tsgwiro1/TWM_Isolation_Variac/README.md

# TWM Isolation Variac

Steuerung für einen motorisierten **Trenn-/Stelltransformator (Isolation Variac)**. Das Projekt
umfasst zwei zusammenarbeitende Firmwares sowie die gemeinsame Dokumentation in einem Mono-Repo.

Der **Controller** (`tt_esp32controller/`, ESP32-S3) fährt über einen Schrittmotor den Schleifer
des Variac und stellt so die Ausgangsspannung ein. Bedienung wahlweise lokal — TFT-Display,
Drehencoder und Tasten (Ein/Aus, Strombegrenzung, Regelung, 3 Presets) — oder über das integrierte
**Web-Interface** mit REST-/WebSocket-API. Dazu kommen temperaturgeregelte Lüftersteuerung,
WLAN-Einrichtung per WiFiManager und Updates over-the-air (OTA).

Das **Voltmeter** (`tt_voltmeter/`, STM32F103) misst die Ausgangsspannung als echten AC-RMS-Wert
(ZMPT101B-Sensor) und liefert ihn laufend über eine serielle Verbindung an den Controller — die
Basis für die geschlossene Spannungsregelung.

**Stand:** Controller-Firmware **V4.9.1** (Git-Tag `v4.9.1`) · Voltmeter-Firmware **V1.2.3**.

Das Projekt auf einer Seite: [`TWM-Isolation-Variac-OnePager.pdf`](TWM-Isolation-Variac-OnePager.pdf).

## Aufbau

| Pfad | Inhalt |
|---|---|
| `tt_esp32controller/` | Controller-Firmware (PlatformIO/Arduino), Web-Oberfläche (`data/`), Controller-Doku (inkl. Trinamic-Treiber, Hardware-Modifikationen) |
| `tt_voltmeter/` | Voltmeter-Firmware (STM32) und Voltmeter-Doku |
| `Hardware/` | [Stückliste](Hardware/Stueckliste.md), [Verdrahtung](Hardware/Verdrahtung.md), die drei Print-Modifikationen ([Leistungsplatine](Hardware/Modifikation-Leistungsplatine.md), [Controller](Hardware/Modifikation-Controller-Print.md), [AC-Voltmeter](Hardware/Modifikation-AC-Voltmeter-Print.md)), Schema/Layout/Gerber/BOM der vier Prints (`PCB/`), Datenblätter, CAD |

Arbeitsstand und geplante Aufgaben: [`BACKLOG.md`](BACKLOG.md) (priorisierter Plan).

## Build & Flash (Controller)

Der Controller wird mit **PlatformIO** (VS Code, Erweiterung „PlatformIO IDE") gebaut.
Alle Befehle im Ordner `tt_esp32controller/` ausführen.

Es gibt drei Environments – kein Umkommentieren mehr nötig:

| Environment | Zweck |
|---|---|
| `esp32s3_usb` | Upload/Monitor über **USB** – erster Flash eines neuen Boards, Recovery |
| `esp32s3_ota` | Upload über **WLAN (OTA)** – täglicher Gebrauch (Default) |
| `esp32s3_sim` | **Simulationsmodus** – Regelung ohne Variac/Voltmeter testen (Spannung wird aus der Stepper-Position simuliert), Upload via OTA wie Standard |

Das Gerät besteht aus **zwei Teilen**, die getrennt geflasht werden:
1. **Firmware** (der Programmcode)
2. **Filesystem** (die Webseiten aus `data/`, als LittleFS-Image)

### Erster Flash (neues Board, nur USB)

```bash
# Board per USB anschließen
pio run -e esp32s3_usb -t upload      # Firmware
pio run -e esp32s3_usb -t uploadfs    # Webseiten (data/)
```

> **Download-Mode** (falls der USB-Port nicht gefunden wird): **BOOT** gedrückt halten,
> kurz **RESET** drücken und loslassen, dann **BOOT** loslassen. Details:
> [`tt_esp32controller/documentation/USB CDC.md`](tt_esp32controller/documentation/USB%20CDC.md).

Danach WLAN einrichten: Das Gerät öffnet beim ersten Start den Access Point
`TWM_IsolationVariac` (WiFiManager). Dort das Heim-WLAN hinterlegen. Nach dem Speichern
startet das Gerät einmal neu und ist anschließend unter `http://twm-variac.local/`
erreichbar. Der Name lässt sich in den Einstellungen ändern.

> **Der Variac startet immer, auch ohne WLAN.** Seit V4.4.0 wird das Netz erst nach der
> Hardware aufgebaut: Ein Verbindungsversuch, bei Misserfolg das Konfigurationsportal,
> und wenn dort 10 Minuten nichts passiert, schaltet das Funkmodul ab. Das Gerät bleibt
> voll bedienbar — nur ohne Web und API. Ein neuer Verbindungsversuch braucht einen
> Neustart.

### Updates über OTA (Standard)

```bash
pio run -e esp32s3_ota -t upload      # Firmware via WLAN
pio run -e esp32s3_ota -t uploadfs    # Webseiten via WLAN
```

Wird `-e` weggelassen, gilt das Default-Environment `esp32s3_ota`.

### Serieller Monitor

```bash
pio device monitor          # 115200 Baud (USB-CDC)
```

### Hinweise

- **Hostname/IP:** `upload_port` in `[env:esp32s3_ota]` muss zum Hostname des Geräts
  passen (Standard `twm-variac.local`, änderbar in den Einstellungen). Findet dein Rechner
  den Namen nicht (häufig unter Windows), dort die feste IP eintragen.
- **OTA-Passwort:** Optional in der Firmware aktivierbar; dann in `[env:esp32s3_ota]`
  unter `upload_flags` die Zeile `--auth=...` einkommentieren.
- **Webseiten geändert?** Nach Änderungen in `data/` immer `uploadfs` ausführen –
  ein reiner Firmware-Upload überträgt die Webseiten **nicht**. Der Build erinnert
  daran (siehe unten).

### Versionsstempel

Die Versionsnummer der Controller-Firmware steht in
[`tt_esp32controller/version.txt`](tt_esp32controller/version.txt) — dort und
nirgends sonst. Der Build reicht sie an die Firmware weiter und legt sie zusammen
mit einem Inhalts-Hash über `data/` als `/version.json` ins Filesystem-Image.

Daraus ergeben sich drei Kontrollen, die ohne Zutun laufen:

| Wann | Was gemeldet wird |
|---|---|
| beim Bauen | `data/` hat sich geändert, ohne dass die Version erhöht wurde |
| beim Start des Geräts | Firmware und Filesystem stammen aus verschiedenen Ständen (Log, `/api/status`, Fusszeile) |
| nach einem OTA-Upload | das Gerät entspricht nicht dem Stand im Repo |

Die letzte Prüfung läuft auf dem Build-Rechner, weil nur dort beide Seiten
vorliegen. Sie bricht nie einen Build ab: Bei einem USB-Flash oder einem nicht
erreichbaren Gerät gibt sie einen Hinweis aus und ist fertig.

**Beim Ändern von `data/` oder `src/` also die Version in `version.txt` erhöhen**,
danach `upload` **und** `uploadfs` ausführen — sonst laufen die beiden Stände auf
dem Gerät auseinander, und es sagt es dir.

## Build & Flash (Voltmeter)

Das Voltmeter ist ein eigenes **PlatformIO-Projekt** (STM32F103 „Blue Pill", STM32duino).
Alle Befehle im Ordner `tt_voltmeter/` ausführen. Geflasht wird per **ST-Link (SWD)**.

```bash
pio run                     # bauen
pio run -t upload           # via ST-Link flashen
pio device monitor          # Konsole/Kalibrierung (USB-CDC, USB-Port der Blue Pill)
```

Schnittstellen: **USART1** (PA9/PA10) ist der bidirektionale Befehls-/Datenlink zum Controller
(darüber läuft auch das Voltmeter-FW-Update via Controller), die serielle **Konsole** für
Befehle und Kalibrierung läuft über die native **USB-CDC** (PA11/PA12). Details:
[`tt_voltmeter/documentation/Link-Protokoll.md`](tt_voltmeter/documentation/Link-Protokoll.md).

## Dokumentation

Die **Bedienungs-, Einstellungs- und API-Dokumentation** liegt auf dem Gerät selbst und ist
im Webinterface verlinkt (`http://twm-variac.local/doc_usage.html`): Bedienung inkl.
Status-LED-Blinkcodes, interaktive API-Referenz (aus
[`openapi.yaml`](tt_esp32controller/data/openapi.yaml) — der Single Source of Truth für die
REST-/WebSocket-API) sowie Systemeinstellungen und Kalibrierung.

Ergänzende Dokumente im Repo:

| Dokument | Inhalt |
|---|---|
| [`tt_esp32controller/documentation/Status-LED.md`](tt_esp32controller/documentation/Status-LED.md) | Status-LED-Blinkmuster und Fehlerursachen |
| [`tt_esp32controller/documentation/USB CDC.md`](tt_esp32controller/documentation/USB%20CDC.md) | USB-CDC-Konfiguration, Download-Mode |
| `tt_esp32controller/documentation/Trinamic_*.PNG` | Referenz-Einstellungen des Trinamic-Schrittmotortreibers |
| [`tt_voltmeter/documentation/Link-Protokoll.md`](tt_voltmeter/documentation/Link-Protokoll.md) | Controller↔Voltmeter-Protokoll, Befehlssatz, FW-Update via Controller |

Änderungshistorie je Firmware: [`tt_esp32controller/CHANGELOG.md`](tt_esp32controller/CHANGELOG.md)
und [`tt_voltmeter/CHANGELOG.md`](tt_voltmeter/CHANGELOG.md).

## Haftungsausschluss

Dieses Repository beschreibt ein selbstgebautes Gerät, das am **230-V-Netz**
betrieben wird und an seinem Ausgang bis 253 V führt. Die Unterlagen —
Stückliste, Verdrahtung, Modifikationen, Schemas, Layouts und Firmware —
dokumentieren ein konkretes Einzelstück. Sie sind ohne Gewähr auf Richtigkeit
und Vollständigkeit.

Wer danach baut, umbaut oder misst, tut das auf eigene Verantwortung und muss
die dafür nötigen Kenntnisse mitbringen. Arbeiten an Netzspannung sind in der
Schweiz wie in den meisten Ländern geregelt; die einschlägigen Vorschriften
einzuhalten ist Sache dessen, der die Arbeit ausführt.

Die Autoren übernehmen keine Haftung für Schäden an Personen oder Sachen, die
aus der Nutzung dieser Unterlagen entstehen.

## Lizenz

MIT — siehe [`LICENSE`](LICENSE).
