tsgwiro1/TWM_Isolation_Variac/Hardware/Datenblätter/16x16x25mm TO-220 Heatsink.pdf

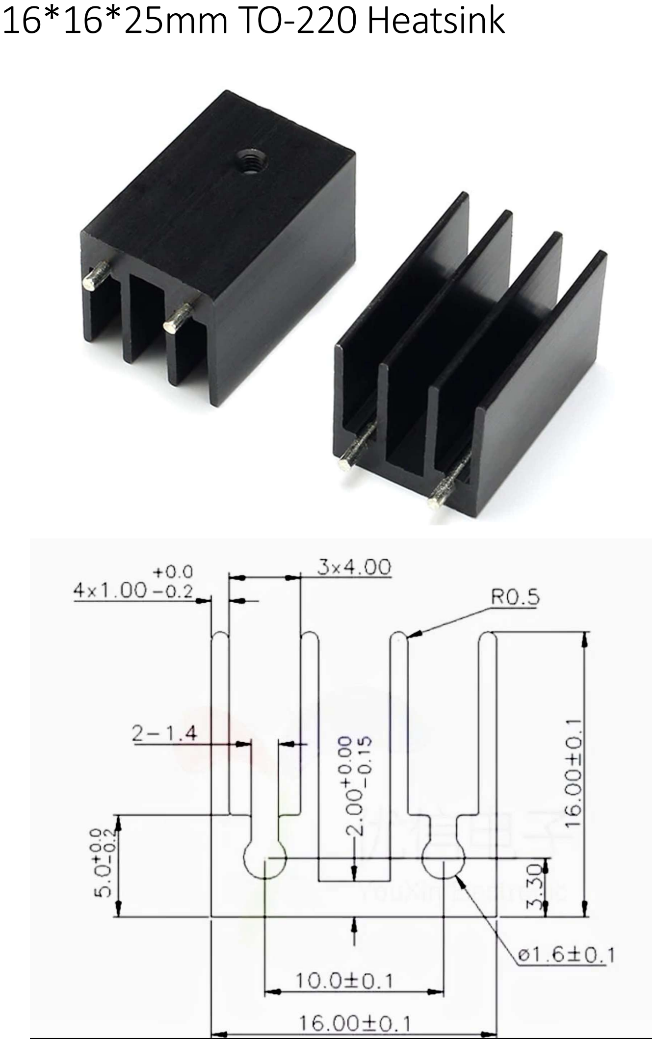
[picture p17: page 1]

16*16*25mm TO-220 Heatsink
