tsgwiro1/TWM_Isolation_Variac/Hardware/PCB/Controller/Layout-Controller.png

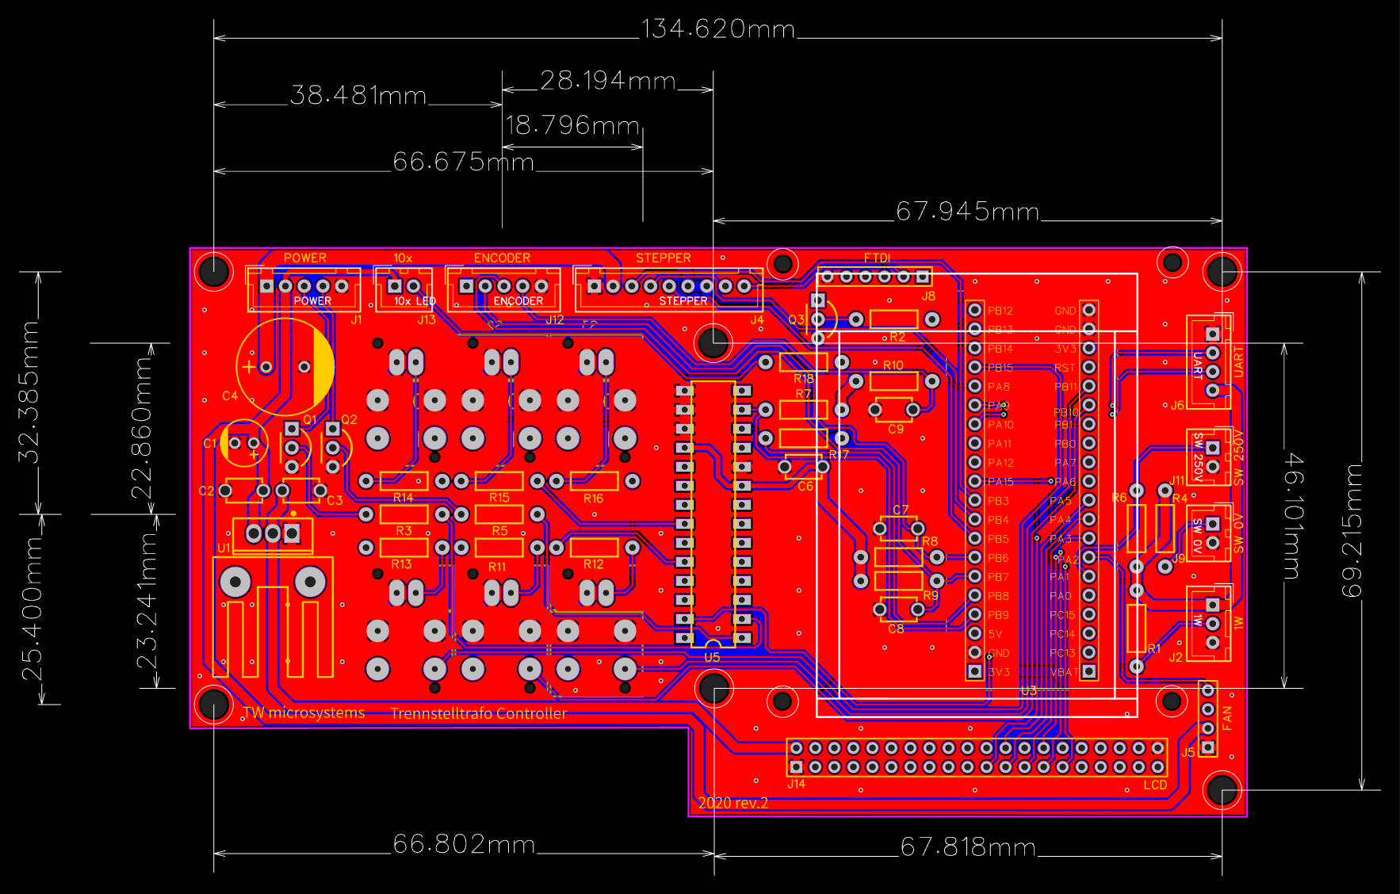
Hardware/PCB/Controller/Layout-Controller.png
