tsgwiro1/TWM_Isolation_Variac/Hardware/PCB/Controller/Schema-Controller.png

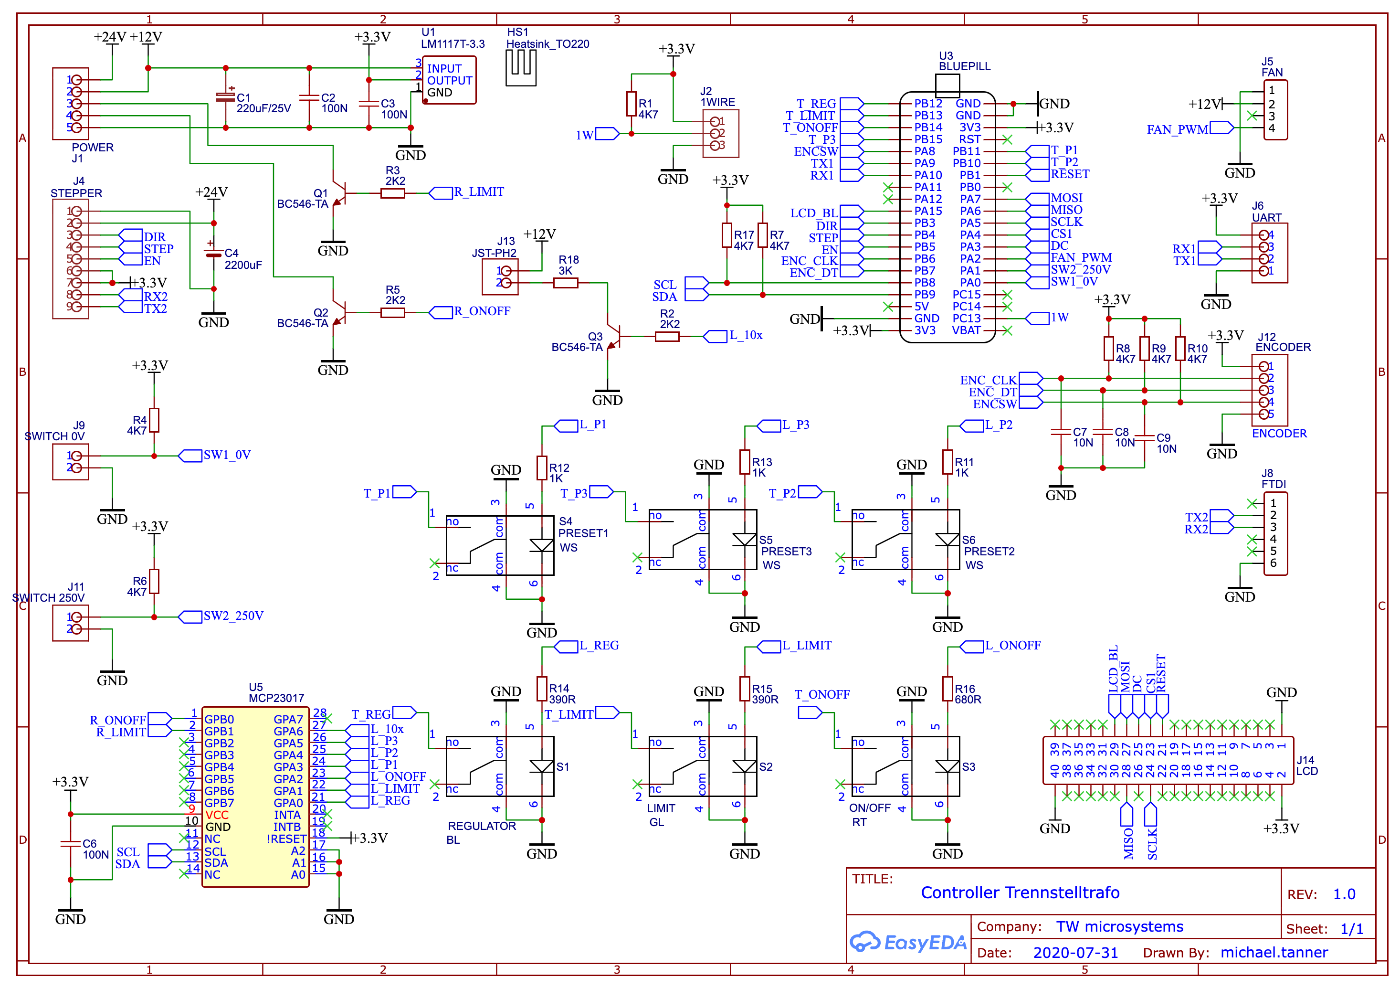
Hardware/PCB/Controller/Schema-Controller.png
