tsgwiro1/TWM_Isolation_Variac/Hardware/PCB/ESP32Board/Layout-ESP32.png

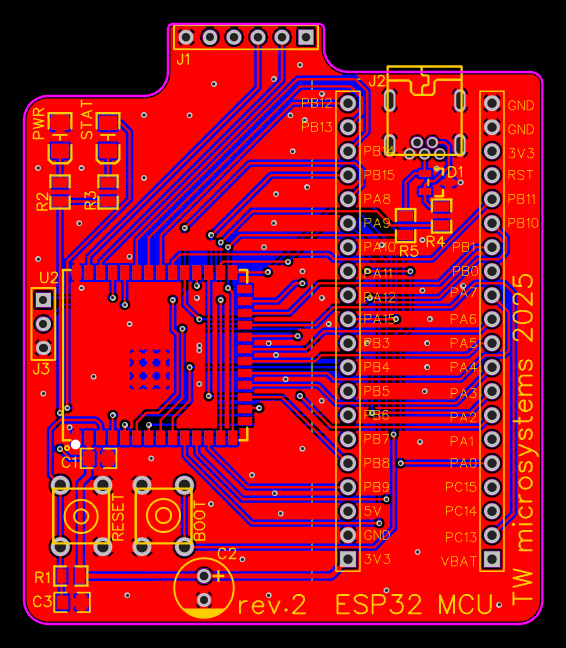
Hardware/PCB/ESP32Board/Layout-ESP32.png
