tsgwiro1/TWM_Isolation_Variac/Hardware/PCB/ESP32Board/Schema-ESP32.png

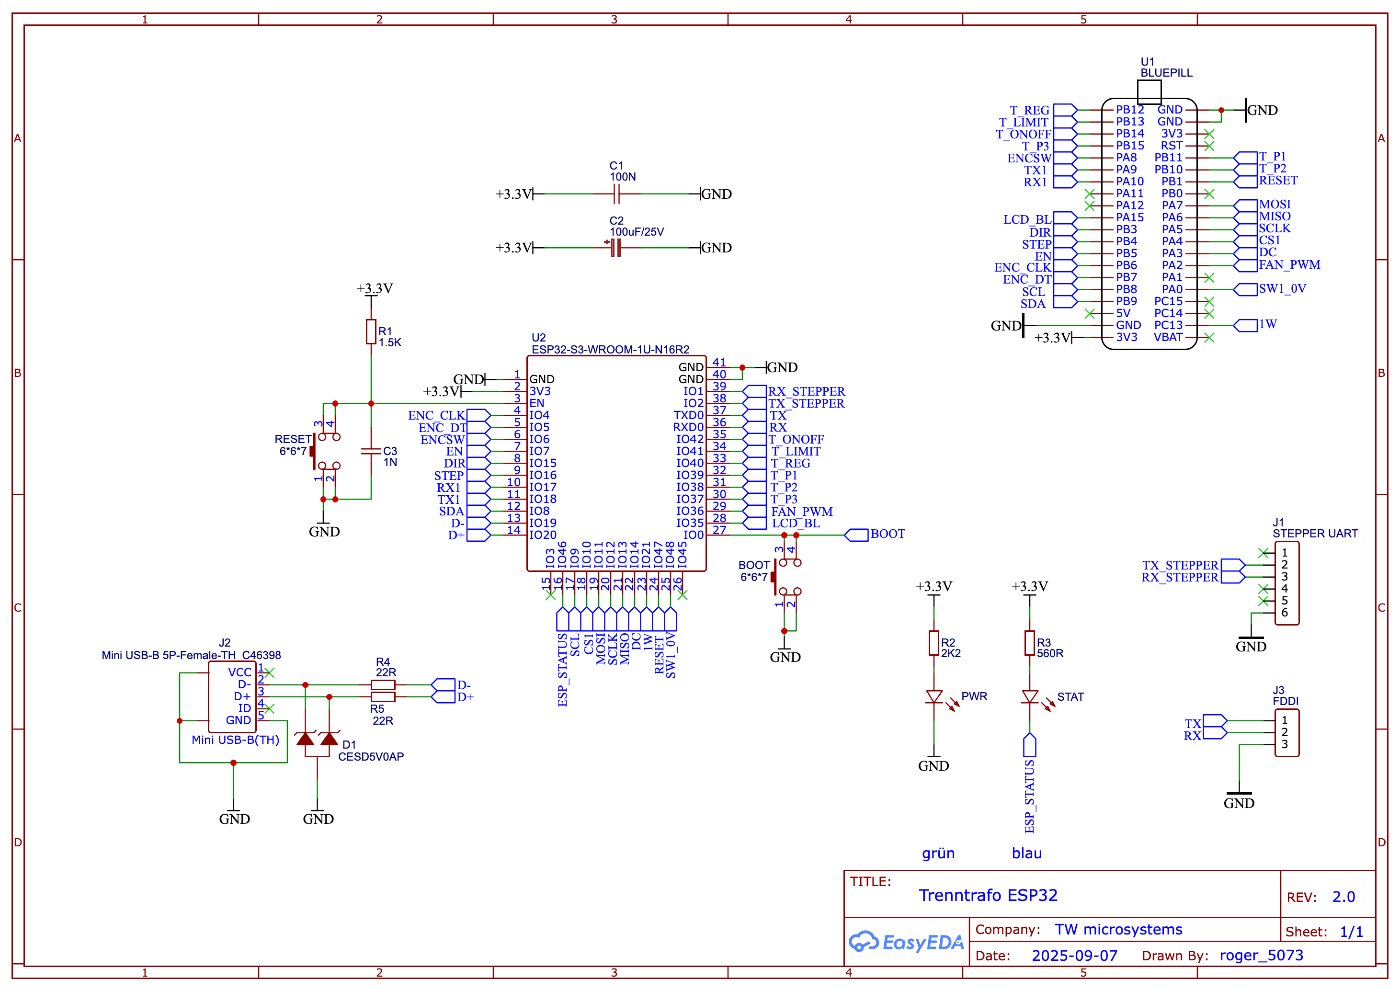
Hardware/PCB/ESP32Board/Schema-ESP32.png
