tsgwiro1/TWM_Isolation_Variac/Hardware/PCB/Power/Layout-Power.png

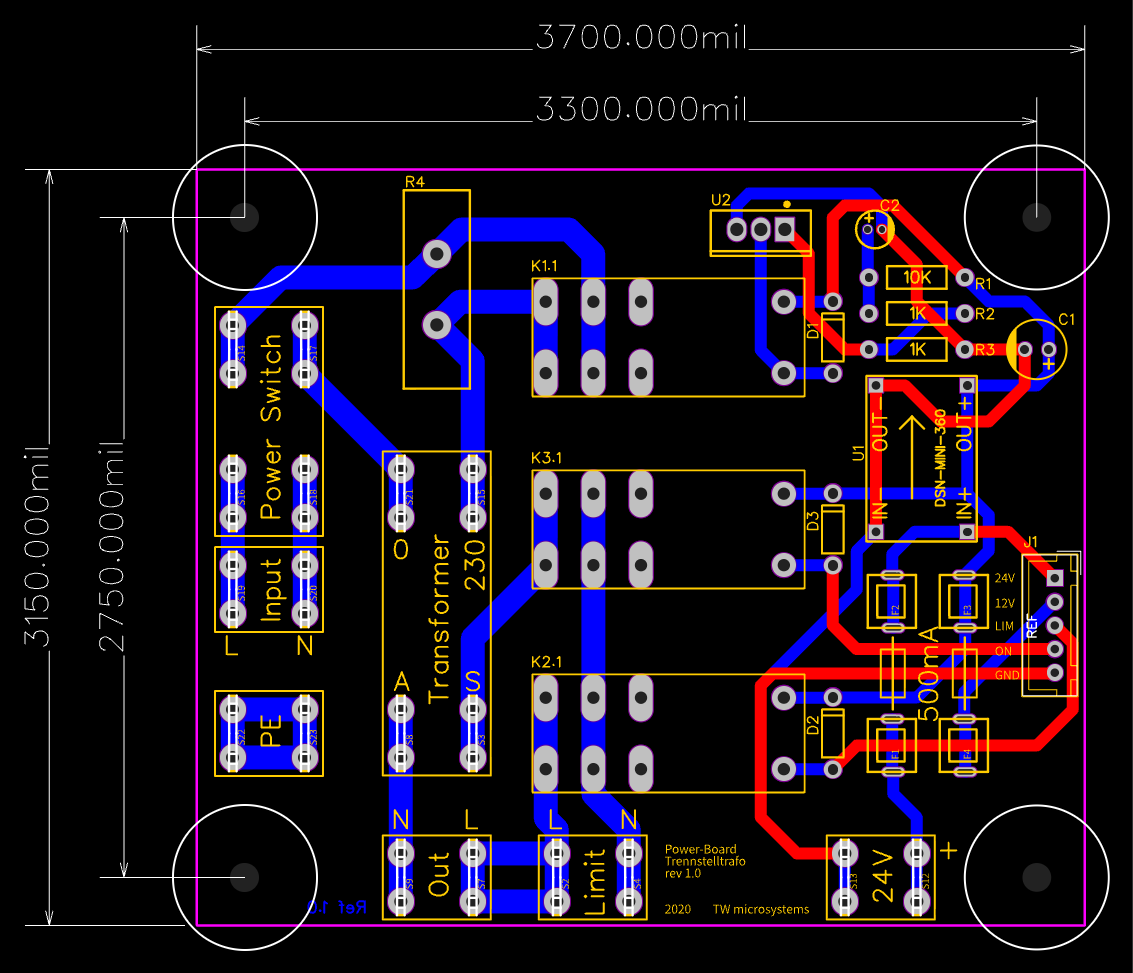
Hardware/PCB/Power/Layout-Power.png
