tsgwiro1/TWM_Isolation_Variac/Hardware/PCB/Power/Schema-Power.png

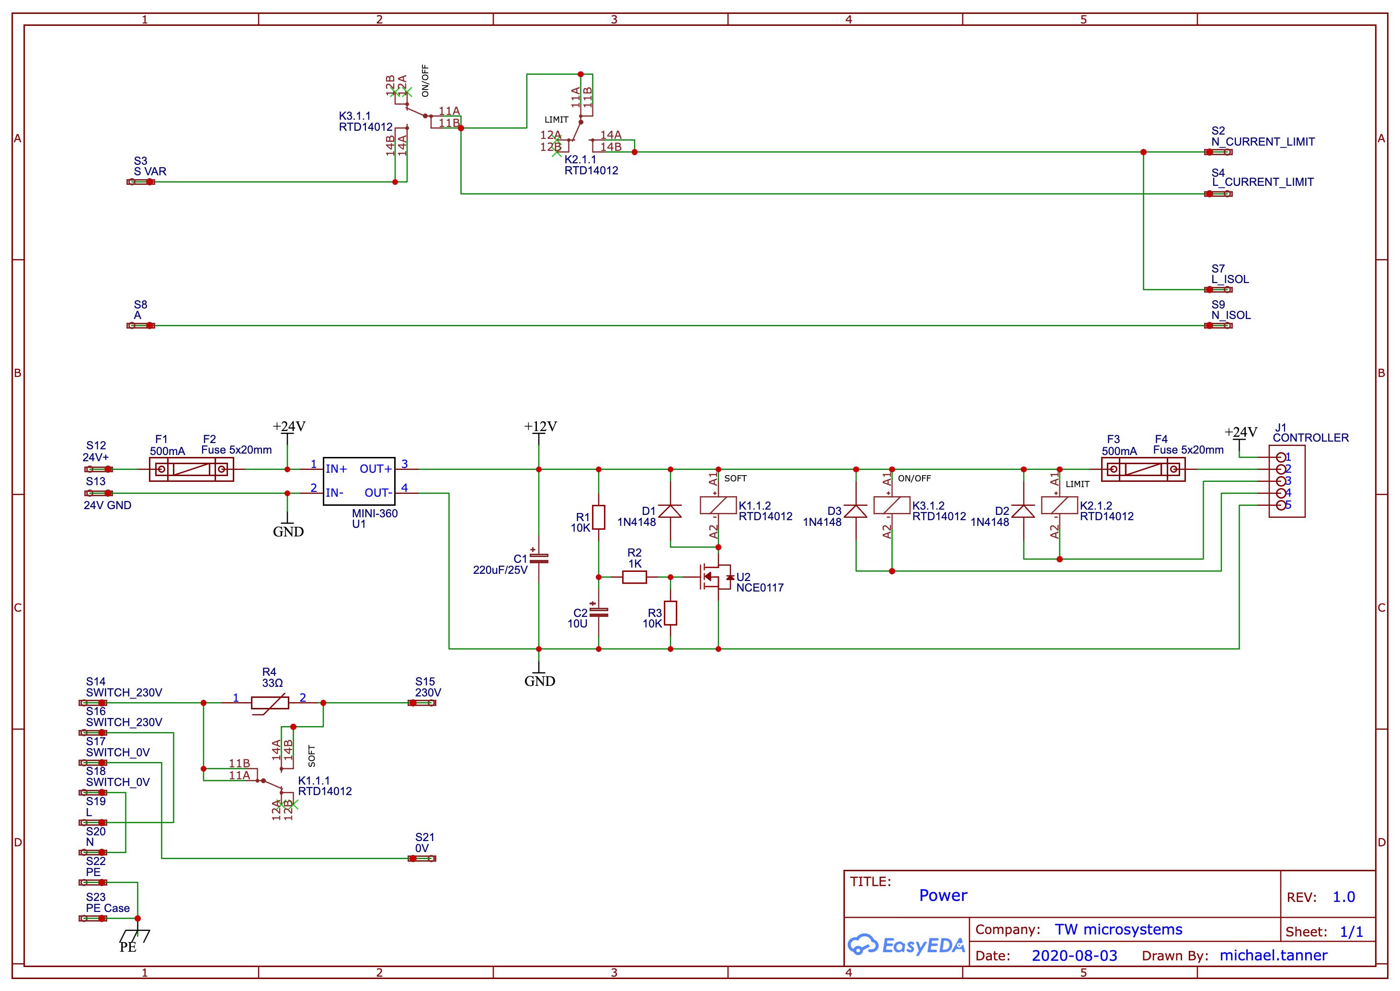
Hardware/PCB/Power/Schema-Power.png
