tsgwiro1/TWM_Isolation_Variac/Hardware/PCB/Voltmeter/Layout-Voltmeter.png

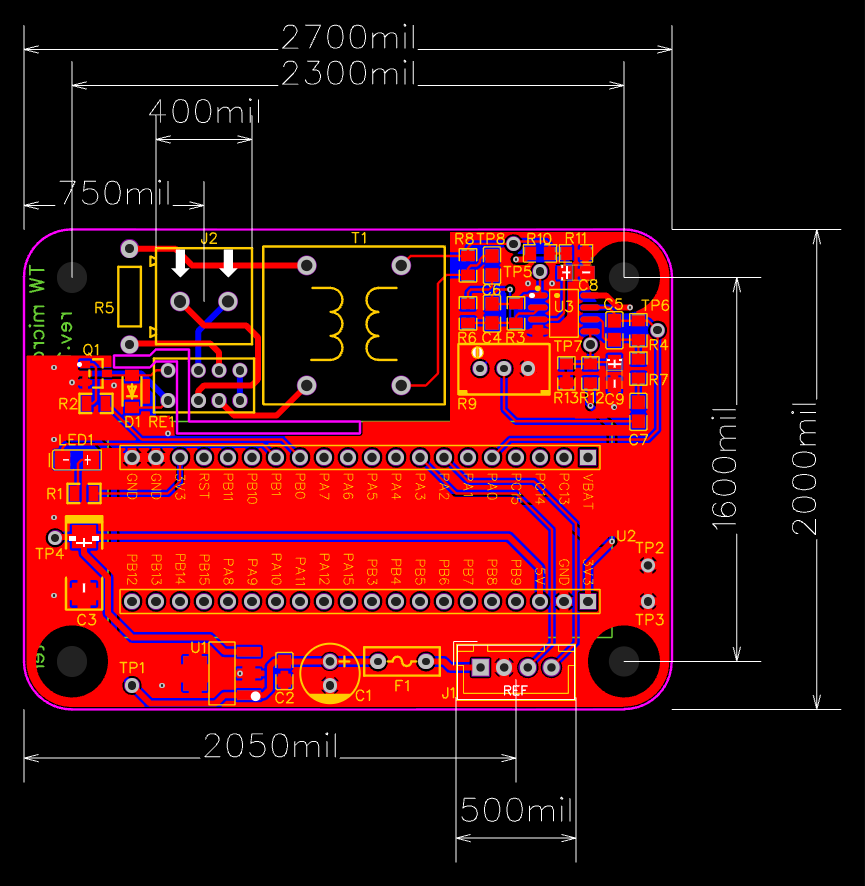
Hardware/PCB/Voltmeter/Layout-Voltmeter.png
