tsgwiro1/TWM_Isolation_Variac/Hardware/PCB/Voltmeter/Schema-Voltmeter.png

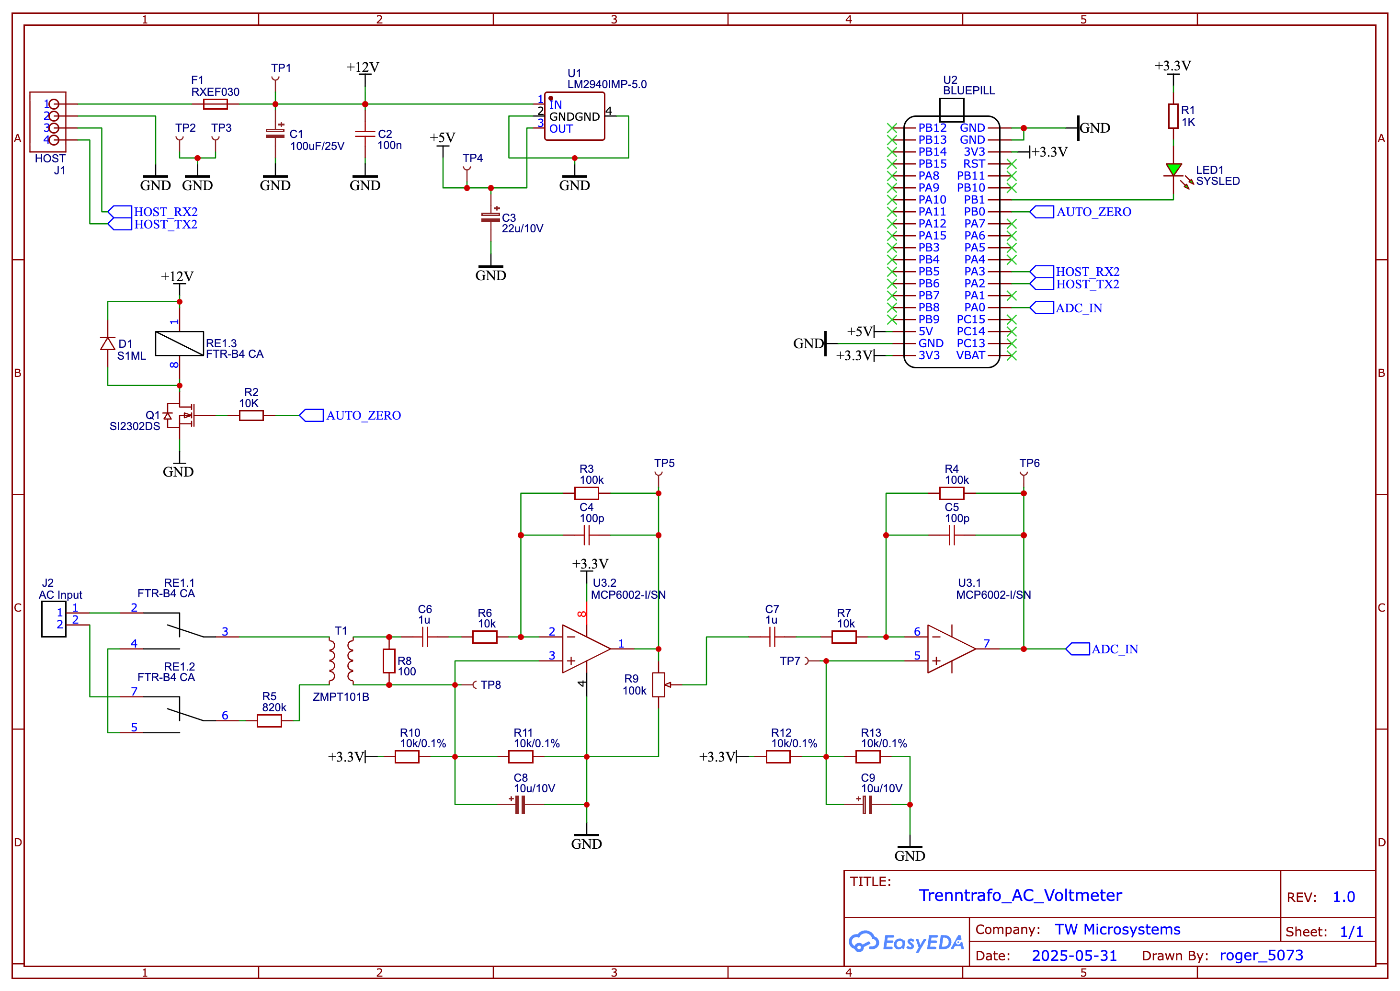
Hardware/PCB/Voltmeter/Schema-Voltmeter.png
