tsgwiro1/TWM_Isolation_Variac/tt_esp32controller/documentation/Trinamic_StealthChop.PNG

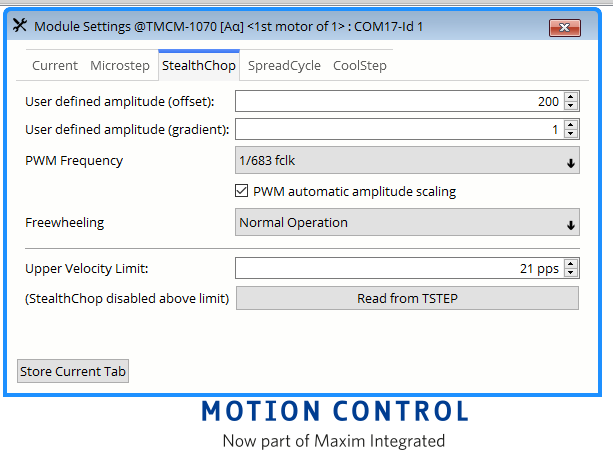
tt_esp32controller/documentation/Trinamic_StealthChop.PNG
