tsgwiro1/TWM_Isolation_Variac/Hardware/PCB/Controller/BOM_Trennstelltrafo_2026-09-13.csv

ID | Name | Designator | Footprint | Quantity
1 | 220uF/25V | C1 | CAP-D6.3×F2.5 | 1
2 | 100N | C2,C3,C6 | CAP-TH_L4.8-W3.2-P5.08-D1.2 | 3
3 | 2200uF | C4 | CAP-D13.0XF5.0 | 1
4 | 10N | C7,C8,C9 | CAP-TH_L4.8-W3.2-P5.08-D1.2 | 3
5 | Heatsink_TO220 | HS1 | HEATSINK_TO220_16X16 | 1
6 | POWER | J1 | JST_XH_B05B-XH-A_05X2.50MM_STRAIGHT | 1
7 | 1WIRE | J2 | JST_XH_B03B-XH-A_03X2.50MM_STRAIGHT | 1
8 | STEPPER | J4 | JST_XH_B09B-XH-A_09X2.50MM_STRAIGHT | 1
9 | FAN | J5 | HDR-F-2.54_1X4 | 1
10 | UART | J6 | JST_XH_B04B-XH-A_04X2.50MM_STRAIGHT | 1
11 | FTDI | J8 | HDR-F-2.54_1X6 | 1
12 | SWITCH 0V | J9 | JST_XH_B02B-XH-A_02X2.50MM_STRAIGHT | 1
13 | SWITCH 250V | J11 | JST_XH_B02B-XH-A_02X2.50MM_STRAIGHT | 1
14 | ENCODER | J12 | JST_XH_B05B-XH-A_05X2.50MM_STRAIGHT | 1
15 | JST-PH2 | J13 | JST_XH_B02B-XH-A_02X2.50MM_STRAIGHT | 1
16 | LCD | J14 | HDR-20X2/2.54 | 1
17 | BC546-TA | Q1,Q2,Q3 | TO-92-3_L4.9-W3.7-P2.54-L | 3
18 | 4K7 | R1,R4,R6,R7,R8,R9,R10,R17 | R_AXIAL-0.4 | 8
19 | 2K2 | R2,R3,R5 | R_AXIAL-0.4 | 3
20 | 1K | R11,R12,R13 | R_AXIAL-0.4 | 3
21 | 390R | R14,R15 | R_AXIAL-0.4 | 2
22 | 680R | R16 | R_AXIAL-0.4 | 1
23 | 3K | R18 | R_AXIAL-0.4 | 1
24 | REGULATOR | S1 | DIGITAST_LED_HOLE1MM | 1
25 | LIMIT | S2 | DIGITAST_LED_HOLE1MM | 1
26 | ON/OFF | S3 | DIGITAST_LED_HOLE1MM | 1
27 | PRESET1 | S4 | DIGITAST_LED_HOLE1MM | 1
28 | PRESET3 | S5 | DIGITAST_LED_HOLE1MM | 1
29 | PRESET2 | S6 | DIGITAST_LED_HOLE1MM | 1
30 | LM1117T-3.3 | U1 | TO-220-3_L10.0-W4.5-P2.54-L | 1
31 | BLUEPILL | U3 | BLUEPILL | 1
32 | MCP23017 | U5 | DIL-28-3 | 1
