tsgwiro1/TWM_Isolation_Variac/Hardware/PCB/ESP32Board/BOM_Trenntrafo_ESP32_2026-09-13.csv

ID | Name | Designator | Footprint | Quantity
1 | 6*6*7 | BOOT,RESET | KEY-6.0*6.0-2 | 2
2 | 100N | C1 | 0805 | 1
3 | 100uF/25V | C2 | CAP-D6.3×F2.5 | 1
4 | 1N | C3 | 0805 | 1
5 | CESD5V0AP | D1 | SOT-23(SOT-23-3) | 1
6 | STEPPER UART | J1 | HDR-F-2.54_1X6 | 1
7 | Mini USB-B 5P-Female-TH_C46398 | J2 | USB-MINI-2 | 1
8 | FDDI | J3 | HDR-F-2.54_1X3 | 1
9 | Power | PWR | LED1206-RD | 1
10 | 1.5K | R1 | R0805 | 1
11 | 2K2 | R2 | R0805 | 1
12 | 560R | R3 | R0805 | 1
13 | 22R | R4,R5 | R0805 | 2
14 | Status | STAT | LED1206-RD | 1
15 | BLUEPILL | U1 | BLUEPILL | 1
16 | ESP32-S3-WROOM-1U-N16R2 | U2 | WIRELM-SMD_ESP32-S3-WROOM-1U | 1
