tsgwiro1/TWM_Isolation_Variac/Hardware/PCB/Power/BOM_Trennstelltrafo-Power_2026-09-13.csv

ID | Name | Designator | Footprint | Quantity
1 | 220uF/25V | C1 | CAP-D6.3×F2.5 | 1
2 | 10U | C2 | CAP-D4.0×F1.5 | 1
3 | 1N4148 | D1,D2,D3 | DO-35 | 3
4 | 500mA | F1,F3 | FUSE-TH_5X20RHOSFUSECLIP/SEAT | 2
5 | Fuse 5x20mm | F2,F4 | FUSE-TH_5X20RHOSFUSECLIP/SEAT | 2
6 | CONTROLLER | J1 | JST_XH_B05B-XH-A_05X2.50MM_STRAIGHT | 1
7 | 10K | R1,R3 | R_AXIAL-0.4 | 2
8 | 1K | R2 | R_AXIAL-0.4 | 1
9 | 33Ω | R4 | RES-TH_L21.0-W7.0-P7.50-D1.0-P3.0 | 1
10 | N_CURRENT_LIMIT | S2 | STEK160_100 | 1
11 | S VAR | S3 | STEK160_100 | 1
12 | L_CURRENT_LIMIT | S4 | STEK160_100 | 1
13 | L_ISOL | S7 | STEK160_100 | 1
14 | A | S8 | STEK160_100 | 1
15 | N_ISOL | S9 | STEK160_100 | 1
16 | 24V+ | S12 | STEK160_100 | 1
17 | 24V GND | S13 | STEK160_100 | 1
18 | SWITCH_230V | S14,S16 | STEK160_100 | 2
19 | 230V | S15 | STEK160_100 | 1
20 | SWITCH_0V | S17,S18 | STEK160_100 | 2
21 | L | S19 | STEK160_100 | 1
22 | N | S20 | STEK160_100 | 1
23 | 0V | S21 | STEK160_100 | 1
24 | PE | S22 | STEK160_100 | 1
25 | PE Case | S23 | STEK160_100 | 1
26 | MINI-360 | U1 | DSN-MINI-360 | 1
27 | NCE0117 | U2 | TO-220-3_L10.0-W4.5-P2.54-L | 1
28 | RTD14012 | K1.1,K2.1,K3.1 | RT1-MONO-16A | 3
