tsgwiro1/TWM_Isolation_Variac/Hardware/PCB/Voltmeter/BOM_Trenntrafo_AC_Voltmeter_2026-09-13.csv

ID | Name | Designator | Footprint | Quantity
1 | 100uF/25V | C1 | CAP-D6.3×F2.5 | 1
2 | 100n | C2 | C0805 | 1
3 | 22u/10V | C3 | CASE-C_6032 | 1
4 | 100p | C4,C5 | C0805 | 2
5 | 1u | C6,C7 | C0805 | 2
6 | 10u/10V | C8,C9 | CASE-A_3216 | 2
7 | S1ML | D1 | SOD-123W_L2.9-W2.1-LS4.4-RD | 1
8 | RXEF030 | F1 | FUSE-TH_L8.0-W3.0-P5.08-D0.8 | 1
9 | HOST | J1 | JST_XH_B04B-XH-A_04X2.50MM_STRAIGHT | 1
10 | AC Input | J2 | CONN-TH_2P-P5.00_WJ500V-5.08-2P | 1
11 | SYSLED | LED1 | LED1206-FD_GREEN | 1
12 | SI2302DS | Q1 | SOT-23_L2.9-W1.3-P1.90-LS2.4-BR | 1
13 | 1K | R1 | R0805 | 1
14 | 10K | R2 | R0805 | 1
15 | 100k | R3,R4 | R0805 | 2
16 | 820k | R5 | R_AXIAL-0.4 | 1
17 | 10k | R6,R7 | R0805 | 2
18 | 100 | R8 | R0805 | 1
19 | 100k | R9 | RES-ADJ-TH_3296W | 1
20 | 10k/0.1% | R10,R11,R12,R13 | R0805 | 4
21 | ZMPT101B | T1 | XFMR-TH_ZMPT101B | 1
22 | TEST-POINTTP_15TH_THRU | TP1,TP2,TP3,TP4,TP5,TP6,TP7,TP8 | TP30H | 8
23 | LM2940IMP-5.0 | U1 | SOT-223-4_L6.5-W3.5-P2.30-LS7.0-BR | 1
24 | BLUEPILL | U2 | BLUEPILL | 1
25 | FTR-B4 CA | RE1 | RELAY-TH_FTR-B4CA012Z | 1
26 | MCP6002-I/SN | U3 | SOIC-8_L4.9-W3.9-P1.27-LS6.0-BL | 1
