tsgwiro1/TWM_Isolation_Variac/Hardware/CAD/AC_Voltmeter_Case v7.step

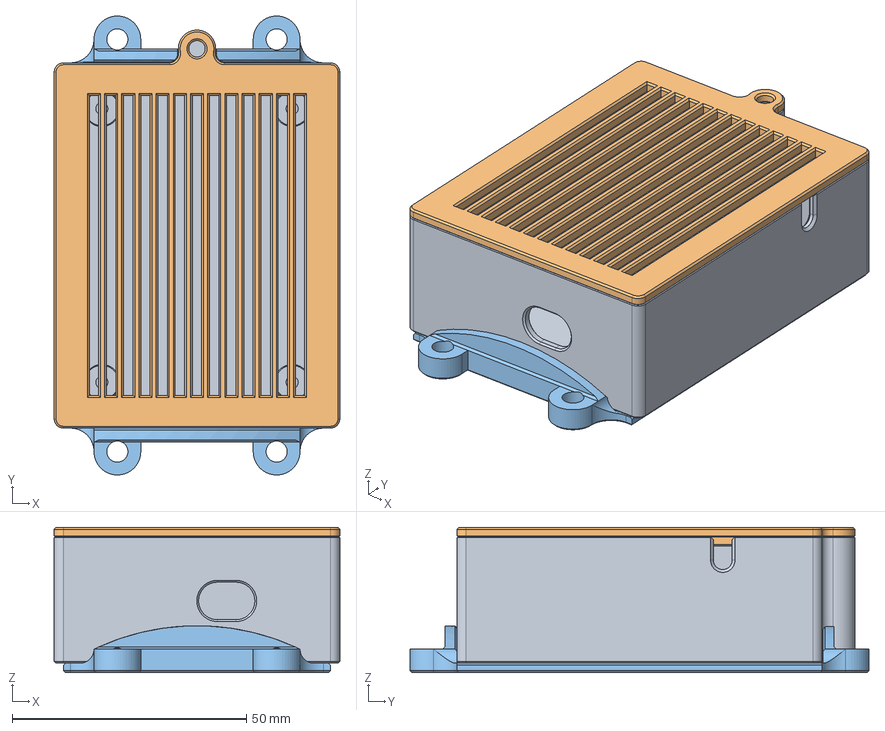
[picture p42: CAD file, 2026-09-13]
Hardware/CAD/AC_Voltmeter_Case v7.step
61.0 x 98.0 x 31.0 mm
AC_Voltmeter_Case_1
AC_Voltmeter_Top
AC_Voltmeter_Base
