tsgwiro1/TWM_Isolation_Variac/Hardware/CAD/Stepper Mount v50.step

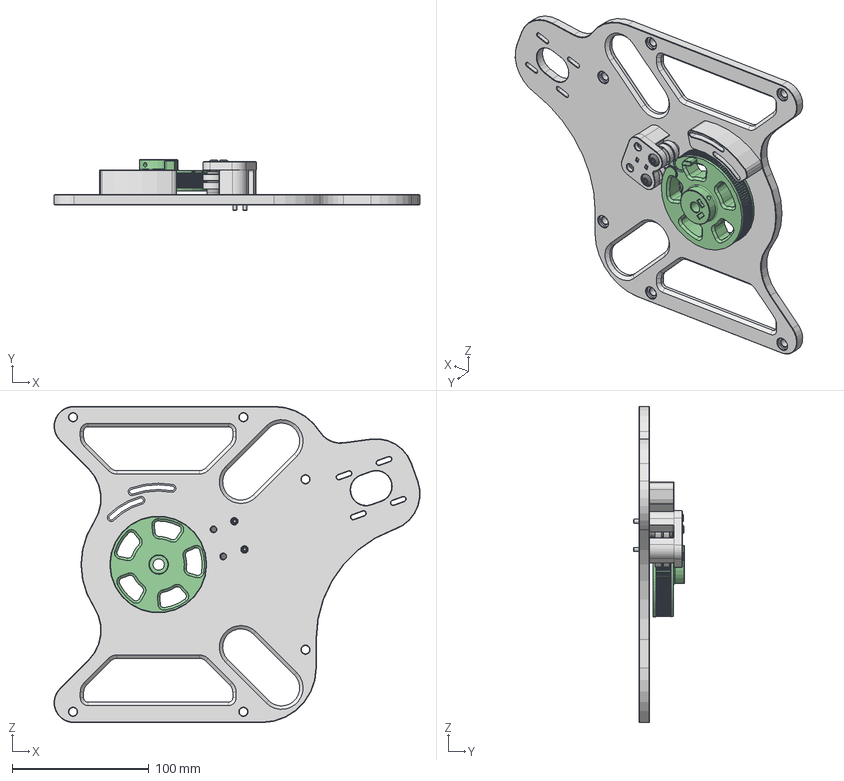
[picture p43: CAD file, 2026-09-13]
Hardware/CAD/Stepper Mount v50.step
267.2 x 37.5 x 231.0 mm
MountingPlate
GT2_Pulley_120 v1
625 2RS (1) (1) x 4
M5 1mm Spacer (1) (1) (1) x 14
M5x30 BHCS (1) x 2
M3 Threaded Insert (1) x 2
M3x30 x 2
