tsgwiro1/TWM_Isolation_Variac/tt_esp32controller/documentation/Trinamic_CoolStep.PNG

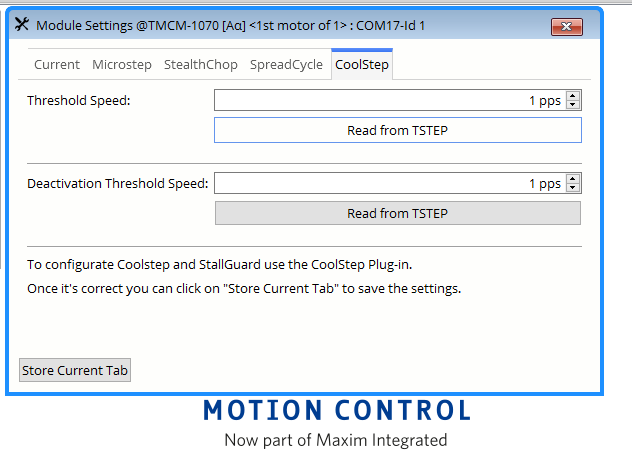
tt_esp32controller/documentation/Trinamic_CoolStep.PNG
