tsgwiro1/TWM_Isolation_Variac/tt_esp32controller/src/tt_esp32controller.ino

/*************************************************************
Copyright(c) 2025 Roger Widmer & Michael Tanner

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
THE SOFTWARE IS PROVIDED "AS IS", WITHOUT WARRANTY OF ANY KIND, EXPRESS OR
IMPLIED, INCLUDING BUT NOT LIMITED TO THE WARRANTIES OF MERCHANTABILITY,
FITNESS FOR A PARTICULAR PURPOSE AND NONINFRINGEMENT.IN NO EVENT SHALL THE
AUTHORS OR COPYRIGHT HOLDERS BE LIABLE FOR ANY CLAIM, DAMAGES OR OTHER
LIABILITY, WHETHER IN AN ACTION OF CONTRACT, TORT OR OTHERWISE, ARISING FROM,
OUT OF OR IN CONNECTION WITH THE SOFTWARE OR THE USE OR OTHER DEALINGS IN
THE SOFTWARE.
************************************************************ */

/*
    Name:       tt_esp32controller.ino
    Created:	  27.09.2025
    Author:     LondonWS\roger
*/

// =============================================================================
// Modularisiert (#10): Die Fachlogik liegt in Modulen (je .h/.cpp):
//   pins.h      Pin-Belegung ESP32-S3 + MCP23017
//   state.*     geteilte Zustände, Enums, Regelparameter, Task-Handles
//   logging.*   thread-sicheres Logging über Queue + Logger-Task (#4)
//   config.*    NVS-Konfiguration + Validierung (#35)
//   motor.*     Stepper, Homing, Spannungsregelung (#17)
//   comm.*      Voltmeter-Link + FW-Update AN3155 (#30)
//   display.*   TFT-Screens + Display-Task
//   actions.*   Tasten/LEDs/Relais, Encoder, Benutzereingaben
//   web.*       REST-API (#22) + WebSocket-Live-Log
//   system.*    Lüfter, Temperatursensor, Status-LED
//   sim.*       Simulationsmodus (#20)
// Hier verbleiben nur setup() und loop().
// =============================================================================

#include <Arduino.h>
#include <FS.h>
#include <LittleFS.h>
using namespace fs;
#include <Wire.h>
#include <SPI.h>
#include <WiFi.h>
#include <ESPmDNS.h>
#include <WiFiUdp.h>
#include <ArduinoOTA.h>
#include <WiFiManager.h>
#include "esp_ota_ops.h"   // OTA-Image als gültig markieren (Rollback abschalten)

#include "pins.h"
#include "state.h"
#include "logging.h"
#include "config.h"
#include "motor.h"
#include "comm.h"
#include "display.h"
#include "actions.h"
#include "web.h"
#include "system.h"
#include "sim.h"

// System
uint32_t lastStackCheck = 0;

static void networkTask(void *parameter);

/**
 * @brief Standard Arduino setup()-Funktion. Wird einmal beim Start ausgeführt.
 * Initialisiert alle Hardware-Komponenten und erstellt die RTOS-Tasks.
 *
 * GitHub-#13/#11: Das Netzwerk wird hier NICHT mehr aufgebaut. Früher lief
 * wm.autoConnect() vor der Hardware-Init — schlug der Connect fehl, blockierte das
 * Config-Portal bis zu 10 Minuten, und das Gerät stand ohne Display, ohne Tasten und
 * mit Lüfter auf 100 % da (PWM-Pin floatet vor initFAN()). Seit V4.4.0 kommt zuerst
 * die komplette Hardware hoch; WLAN/OTA übernimmt danach der networkTask.
 */
void setup() {
  currentSystemState = STATE_STARTING;

  // #4: Logging-Infrastruktur ZUERST, damit ab dem ersten logMessage() alles über die
  // Queue läuft (Serial/Historie/WS/Flash nur noch im Logger-Task).
  loggingInit();

  xTaskCreatePinnedToCore(
      statusLedTask,      // Task-Funktion
      "StatusLED",        // Name
      2048,               // GitHub-#14: von 1024 erhöht — auf Core 0 laufen ISRs (WLAN etc.)
                          // auf dem Stack des aktiven Tasks; 1024 war dafür knapp.
      NULL,               // Parameter
      1,                  // Niedrige Priorität
      &h_statusLedTask,   // GitHub-#14: Handle für die Stack-Überwachung in loop()
      0);                 // Auf Core 0 pinnen

    // GitHub-#14: Die frühere `while (!Serial && ...)`-Schleife entfernt. Sie war
    // wirkungslos (Bedingung invertiert, wartete nie) und dürfte es auch bleiben:
    // `Serial` ist die USB-CDC-Konsole, die im Standalone-Betrieb (kein USB-Kabel) nie
    // verbindet — ein echtes Warten würde jeden Boot um den vollen Timeout verzögern
    // (Gegenteil von GitHub-#13). Das Gerät ist headless und loggt in RAM/Datei/WebSocket.
    Serial.begin(115200);
    logMessage(LOG_INFO, "SYSTEM: Starting system...");

  // OTA-Rollback ist im Framework aktiv (CONFIG_APP_ROLLBACK_ENABLE): ein frisch per OTA
  // geflashtes Image bootet als PENDING_VERIFY und wird sonst beim nächsten frühen Reset
  // (z.B. der sporadische Startup-Watchdog, Reset-Grund "other watchdog") auf die ALTE
  // Partition zurückgerollt — Symptom: "OTA OK", aber nach dem Reboot läuft der alte Stand.
  // Deshalb hier SOFORT (vor Homing/WLAN) selbst als gültig bestätigen, damit ein OTA
  // zuverlässig übernimmt. Diese Firmware nutzt Rollback ohnehin nicht (bestätigt sonst nie).
  {
    const esp_partition_t* running = esp_ota_get_running_partition();
    esp_ota_img_states_t otaState;
    if (running && esp_ota_get_state_partition(running, &otaState) == ESP_OK
        && otaState == ESP_OTA_IMG_PENDING_VERIFY) {
      esp_ota_mark_app_valid_cancel_rollback();
      logMessage(LOG_INFO, "SYSTEM: OTA image confirmed valid (rollback cancelled)");
    }
  }

  // Grund des letzten Neustarts protokollieren (GitHub-#26). Macht im Log auf Anhieb
  // unterscheidbar, ob ein geordneter Reset vorlag (OTA, /api/reboot) oder ein Absturz
  // (Panic/Watchdog) — sonst sieht man nur, dass das Gerät neu gestartet ist.
  {
    const char* why;
    switch (esp_reset_reason()) {
      case ESP_RST_POWERON:  why = "power-on";                break;
      case ESP_RST_SW:       why = "software restart";        break;
      case ESP_RST_PANIC:    why = "PANIC (crash)";           break;
      case ESP_RST_INT_WDT:  why = "interrupt watchdog";      break;
      case ESP_RST_TASK_WDT: why = "task watchdog";           break;
      case ESP_RST_WDT:      why = "other watchdog";          break;
      case ESP_RST_BROWNOUT: why = "brownout (supply)";       break;
      case ESP_RST_EXT:      why = "external reset pin";      break;
      case ESP_RST_DEEPSLEEP: why = "deep-sleep wakeup";      break;
      default:               why = "unknown";                 break;
    }
    logMessage(LOG_INFO, "SYSTEM: Last reset reason: %s", why);
  }

  // Initialisiere die zweite serielle Schnittstelle (USART1 auf PA9/PA10)
  Serial1.begin(115200, SERIAL_8N1, PIN_RX, PIN_TX);
  logMessage(LOG_INFO, "SYSTEM: Serial1 activated - Connection to voltmeter");

#ifdef SIM
  logMessage(LOG_WARN, "SYSTEM: *** SIMULATION MODE - voltmeter input is simulated from stepper position ***");
#endif

  // Initialisiere das LittleFS-Dateisystem
  // GitHub-#13: vorgezogen — loadConfiguration() liest daraus, und der Webserver
  // (später im networkTask) liefert die Seiten daraus aus. Beides darf nicht mehr
  // hinter dem WLAN-Aufbau stehen.
  if(!LittleFS.begin(true, "/littlefs", 10, "spiffs")){
    logMessage(LOG_ERROR, "SYSTEM: Error mounting LittleFS");
    currentSystemState = STATE_ERROR; // Signalisiere einen Fehler
  } else {
    logMessage(LOG_INFO, "SYSTEM: LittleFS mounted successfully.");
    loadFilesystemStamp();   // meldet, wenn Firmware und Image auseinanderlaufen
  }

  initDisplayStruct();
	
  pinMode(PIN_DISP_BL, OUTPUT);
  pinMode(PIN_SW1, INPUT_PULLUP);
  pinMode(PIN_ENCSW, INPUT_PULLUP);

  pinMode(PIN_ENCCLK, INPUT);
  pinMode(PIN_ENCDT, INPUT);


  uint8_t result = 0x00;
  uint8_t retry = 0;
  logMessage(LOG_INFO, "SYSTEM: Initializing I2C...");
	Wire.begin(PIN_SDA, PIN_SCL);
  logMessage(LOG_INFO, "SYSTEM: Initializing MCP23017...");

  logMessage(LOG_INFO, "SYSTEM: Scanning for MCP23017 at 0x20...");
  if (checkI2CDevice(MCP23017_ADDR)) {
    
    // ERFOLGSFALL: Gerät wurde gefunden
    logMessage(LOG_INFO, "SYSTEM: MCP23017 found! Initializing...");
    mcp.init(); // Jetzt können wir den Chip sicher initialisieren
    mcp.portMode(MCP23017Port::A, 0);
    mcp.portMode(MCP23017Port::B, 0);

    // JETZT die Action-Objekte sicher im Speicher erstellen
    A_onoff = new Action(mcp, PIN_T_ONOFF, PIN_LED_ONOFF);
    A_limit = new Action(mcp, PIN_T_LIMIT, PIN_LED_LIMIT);
    A_reg   = new Action(mcp, PIN_T_REG, PIN_LED_REG);
    A_p1    = new Action(mcp, PIN_T_P1, PIN_LED_P1);
    A_p2    = new Action(mcp, PIN_T_P2, PIN_LED_P2);
    A_p3    = new Action(mcp, PIN_T_P3, PIN_LED_P3);
    A_x10   = new Action(mcp, PIN_ENCSW, PIN_LED_x10);

    // Gruppe befüllen
    g[0] = A_p1;
    g[1] = A_p2;
    g[2] = A_p3;

    hardwareInitialized = true;
    currentSystemState = STATE_NORMAL_OPERATION;

  } else {
    
    // FEHLERFALL: Gerät antwortet nicht
    logMessage(LOG_ERROR, "SYSTEM: FATAL ERROR - MCP23017 not found on I2C bus!");
    hardwareInitialized = false;
    currentSystemState = STATE_ERROR;
  }

  // NEU: Erstelle den Mutex für den TFT-Zugriff
  tftMutex = xSemaphoreCreateMutex();
  if (tftMutex == NULL) {
    logMessage(LOG_ERROR, "SYSTEM: FATAL ERROR - Could not create TFT Mutex");
    currentSystemState = STATE_ERROR;
  }
  
  logMessage(LOG_INFO, "SYSTEM: Initializing LCD...");
  tft.init();
  tft.setRotation(2);  // Portrait, Connector 12 o'clock
  clearScreen();
	setScreenBacklight(true);

  if (!hardwareInitialized) {
      currentSystemState = STATE_ERROR;
      logMessage(LOG_ERROR, "SYSTEM: FATAL ERROR - System cannot start!");
      drawErrorScreen();
      while (1);
  }
  logMessage(LOG_INFO, "SYSTEM: Loading config file...");
  loadConfiguration();	
  logMessage(LOG_INFO, "SYSTEM: Initializing temperature sensor...");
  tempSensorAvailable = initTempSensor();
  logMessage(LOG_INFO, "SYSTEM: Initializing fan...");
	initFAN(tempSensorAvailable);

  logMessage(LOG_INFO, "SYSTEM: Initializing stepper...");
    initStepper();          // Semaphore + AccelStepper-Parameter + Ticker/ISR (motor.cpp)

  logMessage(LOG_INFO, "SYSTEM: Initializing encoder...");
    ESP32Encoder::useInternalWeakPullResistors=puType::up;
    encoder.attachFullQuad(PIN_ENCDT, PIN_ENCCLK);
    encoder.setCount(ENCMIDPOINT); // Setzt den Startwert
    lastEncPos = getEncoderCount();

    mcp.writeRegister(MCP23017Register::GPIO_A, 0x00);  //all LED OFF

    
    // Wähle den Start-Modus basierend auf dem gedrückten Taster
    if (!digitalRead(PIN_T_REG)) {
        logMessage(LOG_INFO, "SYSTEM: Setup button pressed, entering SETTINGS MODE");
        is_regulation_active = false;
        // GitHub-#3: Auch im Setup-Einstieg zuerst die Referenz herstellen — ohne
        // Homing würde die zufällige physische Schleifer-Position zur logischen 0
        // und die Min-/Max-Anfahrten könnten in den mechanischen Anschlag fahren.
        drawHomingScreen();
        homing();
        logMessage(LOG_INFO, "SYSTEM: Homing completed");
        clearScreen();
        drawSettingsScreen();
        initSettingsActions();
        cb_SettingsValueAction(A_p1, ButtonEvent::RELEASED); // Min-Punkt anfahren
        currentMode = MODE_SETTINGS;
    } else {
        logMessage(LOG_INFO, "SYSTEM: Starting in NORMAL MODE");
        logMessage(LOG_INFO, "SYSTEM: Initializing actions and homing...");
        initActions();
        drawHomingScreen();
        homing();
        initDisplayStruct();
        drawBackground();
        drawLegend();

        logMessage(LOG_INFO, "SYSTEM: Homing completed");
        currentMode = MODE_NORMAL;
    }

    logMessage(LOG_INFO, "SYSTEM: Initializing RTOS tasks...");
    // Erstelle und starte die Tasks
    xTaskCreatePinnedToCore(
        userInputTask,      // Task-Funktion
        "UserInput",        // Name des Tasks
        4096,               // Stack-Größe in Wörtern
        NULL,               // Task-Parameter
        3,                  // Priorität (höher ist wichtiger)
        &h_userInputTask,   // Task-Handle
        1);                 // Auf Core 1 pinnen

    xTaskCreatePinnedToCore(
        motorControlTask,
        "MotorControl",
        4096,               // Mehr Stack für die komplexe Logik
        NULL,
        2,                  // Normale Priorität
        &h_motorControlTask,
        1);

    xTaskCreatePinnedToCore(
        displayUpdateTask,
        "DisplayUpdate",
        4096,               // Display-Libs brauchen oft mehr Stack
        NULL,
        1,                  // Niedrige Priorität
        &h_displayUpdateTask,
        0);                 // Auf Core 0 pinnen

    xTaskCreatePinnedToCore(
        sensorAndFanTask,
        "SensorFan",
        2048,
        NULL,
        1,
        &h_sensorAndFanTask,
        0);

    xTaskCreatePinnedToCore(
        communicationTask,
        "Communication",
        4096,
        NULL,
        2,
        &h_communicationTask,
        0);

    xTaskCreatePinnedToCore(
        voltmeterUpdateTask,
        "VmUpdate",
        4096,
        NULL,
        1,                    // niedrige Priorität, idlet meistens
        &h_voltmeterUpdateTask,
        1);                   // Core 1, damit der communicationTask auf Core 0 frei bleibt

    xTaskCreatePinnedToCore(
        stepperTask,
        "Stepper",
        2048,
        NULL,
        4,                    // HÖCHSTE Priorität (höher als userInputTask)
        &h_stepperTask,
        1);                   // Auf Core 1, wo auch der User-Input läuft

    // GitHub-#13: Netzwerk ganz zuletzt und in einem eigenen Task — die Bedienung steht
    // damit unabhängig davon, ob und wann das WLAN kommt. Grosszügiger Stack, weil der
    // WiFiManager im Portal-Fall einen eigenen Webserver mitbringt.
    xTaskCreatePinnedToCore(
        networkTask,
        "Network",
        8192,
        NULL,
        1,                    // niedrige Priorität, blockiert die meiste Zeit
        NULL,                 // kein Handle: der Task beendet sich, sobald OTA steht
        0);                   // Core 0, zusammen mit Logger/Display/Comm

    logMessage(LOG_INFO, "SYSTEM: START - RTOS tasks running");
}

/**
 * @brief FreeRTOS Task: baut das WLAN auf und startet OTA/mDNS (GitHub-#13).
 *
 * Läuft bewusst NACH der kompletten Hardware-Init und macht GENAU EINEN Anlauf:
 * Verbindungsversuch mit den gespeicherten Zugangsdaten, bei Misserfolg das
 * Config-Portal (AP) bis zum Timeout. Klappt auch das nicht, schaltet der Task das
 * Funkmodul ab und beendet sich — der Variac läuft ohne Web/API einfach weiter.
 * Wird im Portal ein WLAN gespeichert, startet das Gerät kontrolliert neu (GitHub-#29).
 * Ein neuer Verbindungsversuch erfordert bewusst einen Neustart; endloses
 * Weiterprobieren würde im Hintergrund Rechenzeit und Funk belegen, ohne dass am
 * Gerät jemand davon erfährt.
 */
static void networkTask(void *parameter) {
  // GitHub-#28: Hostname aus der Konfiguration; gilt für DHCP (Name im Router) und mDNS.
  // Einmal beim Start übernommen — eine Änderung wirkt deshalb erst nach einem Neustart.
  strlcpy(activeHostname, configHostname().c_str(), sizeof(activeHostname));
  WiFi.setHostname(activeHostname);   // Name, der im Router angezeigt wird

  // Der WiFiManager muss den Task überleben, solange das Portal offen ist.
  static WiFiManager wm;
  wm.setConfigPortalTimeout(600);   // Portal nach 10 min schliessen
  // GitHub-#30: Portal nicht blockierend betreiben. Im blockierenden Modus dreht der
  // WiFiManager seine Schleife nur mit yield(), das Rechenzeit nur an Tasks gleicher oder
  // höherer Priorität abgibt. Hält ein Client (Handy mit Captive-Portal) eine Verbindung
  // offen, ohne zu senden, wartet der Webserver bis zu 5 s ohne Pause — der Idle-Task auf
  // Core 0 kommt nicht zum Zug, und der Task-Watchdog (5 s) startet das Gerät neu, mitten
  // in der Passworteingabe. Die eigene Schleife unten pausiert bei jedem Durchlauf.
  wm.setConfigPortalBlocking(false);
  wm.setAPCallback([](WiFiManager *myWiFiManager) {
    if (currentSystemState != STATE_ERROR) currentSystemState = STATE_WIFIMANAGER_AP;
    logMessage(LOG_WARN, "WLAN: Connect failed - config portal open (AP 'TWM_IsolationVariac')");
  });

  bool connected = wm.autoConnect("TWM_IsolationVariac");

  while (!connected && wm.getConfigPortalActive()) {
    if (wm.process()) {
      // GitHub-#29: Neues WLAN im Portal gespeichert und verbunden. Direkt danach blieben
      // Webseite und API unerreichbar — der Webserver übernimmt Port 80 vom eben
      // geschlossenen Portal nicht zuverlässig. Deshalb kontrolliert neu starten; danach
      // verbindet sich das Gerät mit den gespeicherten Zugangsdaten direkt.
      logMessage(LOG_WARN, "WLAN: New network saved via config portal - restarting to start web server and API");
      stopWiperMove();
      forceSafeState();
      delay(500);          // Logger-Task: Queue leeren
      logFlushToFile();    // Sammelpuffer sichern
      LittleFS.end();      // Unmount = alles committet (siehe OTA onError)
      delay(50);
      ESP.restart();
    }
    vTaskDelay(pdMS_TO_TICKS(5));
  }

  if (!connected) {
    // Weder Verbindung noch Konfiguration über das Portal: Funk komplett abschalten
    // und aufgeben. Die Bedienung am Gerät ist davon nicht betroffen.
    logMessage(LOG_ERROR, "WLAN: No connection, config portal timed out - continuing WITHOUT network (no web, no API). Restart the device to try again.");
    WiFi.softAPdisconnect(true);   // Config-AP abschalten
    WiFi.mode(WIFI_OFF);
    if (currentSystemState != STATE_ERROR) currentSystemState = STATE_NORMAL_OPERATION;
    vTaskDelete(NULL);
  }

  logMessage(LOG_INFO, "WLAN: Successfully connected to WiFi!");
  if (currentSystemState != STATE_ERROR) currentSystemState = STATE_NORMAL_OPERATION;

  // WiFi-Modem-Sleep deaktivieren: hält das Funkmodul wach -> schnelleres OTA
  // und reaktiveres Web-Interface (geringfügig höhere Stromaufnahme).
  WiFi.setSleep(false);

  // Webserver erst jetzt starten: Im Portal-Fall belegt der WiFiManager selbst
  // Port 80 — ein vorher gestarteter AsyncWebServer würde damit kollidieren.
  initWebServer();

  // --- OTA (Over-the-Air) Konfiguration ---

  // Hostname für den Netzwerk-Port in der Arduino IDE und den Zugang via mDNS
  ArduinoOTA.setHostname(activeHostname);

  // Optional aber empfohlen: Passwort für den Upload setzen
  // ArduinoOTA.setPassword("dein_sicheres_passwort");

  ArduinoOTA
    .onStart([]() {
      // GitHub-#26: Ab hier ist der Variac gesperrt — Ausgang aus, Regelung aus, laufende
      // Bewegung ausgebremst, keine Eingaben mehr (Tasten/Encoder via userInputTask,
      // Webseite/API via controlsLocked() im Webserver).
      otaIsFilesystem = (ArduinoOTA.getCommand() != U_FLASH);
      otaProgress = 0;
      otaActive = true;
      currentSystemState = STATE_OTA_UPDATE; // Zustand auf OTA-Update setzen
      stopWiperMove();   // nur stepperMux — aus jedem Kontext zulässig
      // Sicherer Grundzustand: Ausgang aus, Strombegrenzung ein, Regelung aus, Preset- und
      // x10-LEDs aus (Wire/MCP ist thread-safe, wie beim Voltmeter-Update).
      forceSafeState();
      logMessage(LOG_WARN, "OTA: Start updating %s - Variac locked, output OFF",
                 otaIsFilesystem ? "filesystem" : "sketch");
    })
    .onEnd([]() {
      // Kein Entsperren: ArduinoOTA startet das Gerät nach dem Update selbst neu.
      otaProgress = 100;
      currentSystemState = STATE_NORMAL_OPERATION; // Zurück zum Normalbetrieb
      logMessage(LOG_INFO, "OTA: Update finished - Rebooting");
      ws.closeAll();
    })
    .onProgress([](unsigned int progress, unsigned int total) {
      // GitHub-#23: nur alle 25 % eine Meldung (0/25/50/75/100). Vorher feuerte der
      // Callback pro Chunk (bei 10-MB-Filesystem Hunderte Male) und flutete die Queue.
      // Division abgesichert (total kann klein sein).
      static int lastStep = -1;
      int pct = (total > 0) ? (int)((uint64_t)progress * 100 / total) : 0;
      otaProgress = pct;     // GitHub-#26: feine Auflösung für den TFT-Screen
      int step = pct / 25;   // 0..4
      if (step != lastStep) {
        lastStep = step;
        logMessage(LOG_INFO, "OTA: Progress: %d%%", step * 25);
      }
    })
    .onError([](ota_error_t error) {
      // GitHub-#26: Auch ein Abbruch endet im Neustart — so ist der Zustand nach einem
      // OTA immer definiert (Ausgang aus, Regelung aus, Schleifer neu referenziert).
      // Die Sperre bleibt bis zum Reset aktiv, damit in diesem Fenster niemand mehr
      // etwas schalten kann.
      currentSystemState = STATE_ERROR; // Fehlerzustand bei OTA-Problem
      const char* reason = "unknown";
      if (error == OTA_AUTH_ERROR)         reason = "auth failed";
      else if (error == OTA_BEGIN_ERROR)   reason = "begin failed";
      else if (error == OTA_CONNECT_ERROR) reason = "connect failed";
      else if (error == OTA_RECEIVE_ERROR) reason = "receive failed";
      else if (error == OTA_END_ERROR)     reason = "end failed";
      logMessage(LOG_ERROR, "OTA: FAILED - %s (error %u) - rebooting", reason, error);
      if (otaIsFilesystem) {
        logMessage(LOG_ERROR, "OTA: Filesystem may be incomplete - repeat the upload");
      }
      // Die Meldungen müssen den Reset überleben. Reine Wartezeit plus logFlushToFile()
      // genügt dafür nicht: Kommt der Reset, bevor LittleFS seine Metadaten
      // durchgeschrieben hat, wächst die Datei nur — der Inhalt bleibt gelöschtes Flash
      // (0xFF). Deshalb das Dateisystem vor dem Reset ausdrücklich schliessen.
      delay(500);          // Logger-Task: Queue leeren (ERROR flusht selbst in die Datei)
      logFlushToFile();    // Reste des Sammelpuffers sichern
      LittleFS.end();      // Unmount = alles committet
      delay(50);
      ESP.restart();
    });

  ArduinoOTA.begin();
  otaReady = true;   // ab jetzt darf loop() ArduinoOTA.handle() aufrufen

  logMessage(LOG_INFO, "SYSTEM: OTA & mDNS ready. Access at http://%s.local/", activeHostname);
  logMessage(LOG_INFO, "SYSTEM: IP address: %s", WiFi.localIP().toString().c_str());

  // Aufgabe erledigt — der Task wird nicht mehr gebraucht (ArduinoOTA.handle() läuft
  // in loop()) und gibt seinen 8-KB-Stack wieder frei.
  vTaskDelete(NULL);
}

// ********************************************************************************
// Main program loop
// ********************************************************************************
/**
 * @brief Standard Arduino loop()-Funktion.
 * Läuft in einem eigenen Task und kümmert sich um Hintergrund-Dienste wie OTA-Updates.
 */
void loop() {
  // Diese Funktion muss im Loop aufgerufen werden, damit OTA Anfragen
  // empfangen und verarbeitet werden können.
  // GitHub-#13: erst ab dem Moment, in dem der networkTask OTA aufgesetzt hat.
  if (otaReady) ArduinoOTA.handle();

  // Live-Status an die Dashboard-Clients pushen (#13, alle 500 ms)
  static uint32_t lastStatusPush = 0;
  if (millis() - lastStatusPush > 500) {
    lastStatusPush = millis();
    webPushStatus();
  }

  // Alle 5 Sekunden die Stacks aller Tasks auf kritische Werte prüfen
  if (millis() - lastStackCheck > 5000) {
    lastStackCheck = millis();
    
    // Eine Liste aller Task-Handles, die wir überwachen wollen
    TaskHandle_t tasksToCheck[] = {
        h_userInputTask,
        h_motorControlTask,
        h_displayUpdateTask,
        h_sensorAndFanTask,
        h_communicationTask,
        h_stepperTask,
        h_loggerTask,
        h_statusLedTask     // GitHub-#14: jetzt mitüberwacht
    };

    for (TaskHandle_t taskHandle : tasksToCheck) {
      if (taskHandle != NULL) {
        // Ermittle die High Water Mark in Bytes
        uint32_t hwm_bytes = uxTaskGetStackHighWaterMark(taskHandle) * sizeof(StackType_t);
        
        // Gib NUR DANN eine Warnung aus, wenn der Wert kritisch ist
        if (hwm_bytes < CRITICAL_STACK_THRESHOLD) {
          // pcTaskGetName() holt den Namen, den wir in xTaskCreate vergeben haben
          logMessage(LOG_WARN, "SYSTEM: !!! STACK WARNING - Task '%s' has only %u Bytes free !!!", pcTaskGetName(taskHandle), hwm_bytes);
        } else {
          //logMessage(LOG_INFO, "STACK - Task '%s' has %u Bytes free !!!", pcTaskGetName(taskHandle), hwm_bytes);
        }
      }
    }
  }

  // Die loop() darf nicht blockieren, daher nur eine minimale Pause
  vTaskDelay(pdMS_TO_TICKS(10));
}
