tsgwiro1/TWM_Isolation_Variac/tt_esp32controller/src/thermo_icon.h

// Auto-generiert: Thermometer-Icon (weiss, AA, ohne Skalenstriche) RGB565 auf Schwarz.
#pragma once
#include <stdint.h>
#ifndef PROGMEM
#define PROGMEM
#endif
#define THERMO_W 16
#define THERMO_H 28
const uint16_t thermoIcon[] PROGMEM = {
  0x0000,0x0000,0x0000,0x0000,0x0000,0x0000,0x0000,0x0000,0x0000,0x0000,0x0000,0x0000,
  0x0000,0x0000,0x0000,0x0000,0x0000,0x0000,0x0000,0x0000,0x0000,0x0000,0x0000,0x0841,
  0x0861,0x0000,0x0000,0x0000,0x0000,0x0000,0x0000,0x0000,0x0000,0x0000,0x0000,0x0000,
  0x0000,0x1082,0x8C71,0xE73C,0xF79E,0xAD55,0x2124,0x0000,0x0000,0x0000,0x0000,0x0000,
  0x0000,0x0000,0x0000,0x0000,0x0020,0xBDD7,0xFFFF,0xFFFF,0xF7BE,0xFFFF,0xEF5D,0x18C3,
  0x0000,0x0000,0x0000,0x0000,0x0000,0x0000,0x0000,0x0000,0x4A69,0xFFFF,0xE71C,0x39C7,
  0x18C3,0xC618,0xFFFF,0x8C71,0x0000,0x0020,0x0000,0x0000,0x0000,0x0000,0x0020,0x0000,
  0x7BEF,0xFFFF,0x7BCF,0x0000,0x0000,0x39C7,0xFFFF,0xBDF7,0x0000,0x0000,0x0000,0x0000,
  0x0000,0x0000,0x0020,0x0000,0x7BCF,0xFFFF,0x7BCF,0x0000,0x0000,0x39E7,0xFFFF,0xBDD7,
  0x0000,0x0000,0x0000,0x0000,0x0000,0x0000,0x0020,0x0000,0x7BCF,0xFFFF,0x7BCF,0x0000,
  0x0000,0x39E7,0xFFFF,0xBDD7,0x0000,0x0000,0x0000,0x0000,0x0000,0x0000,0x0020,0x0000,
  0x7BCF,0xFFFF,0x7BCF,0x0000,0x0000,0x39E7,0xFFFF,0xBDD7,0x0000,0x0000,0x0000,0x0000,
  0x0000,0x0000,0x0020,0x0000,0x7BCF,0xFFFF,0x7BCF,0x0000,0x0000,0x39E7,0xFFFF,0xBDD7,
  0x0000,0x0000,0x0000,0x0000,0x0000,0x0000,0x0020,0x0000,0x7BCF,0xFFFF,0x7BEF,0x0000,
  0x0000,0x4208,0xFFFF,0xBDD7,0x0000,0x0000,0x0000,0x0000,0x0000,0x0000,0x0020,0x0000,
  0x7BCF,0xFFFF,0x738E,0x0000,0x0841,0x3186,0xFFFF,0xBDD7,0x0000,0x0000,0x0000,0x0000,
  0x0000,0x0000,0x0020,0x0000,0x7BEF,0xFFFF,0x8C71,0xBDD7,0xE71C,0x738E,0xFFFF,0xBDF7,
  0x0000,0x0000,0x0000,0x0000,0x0000,0x0000,0x0020,0x0000,0x8410,0xFFFF,0xFFFF,0xFFFF,
  0xFFFF,0xFFFF,0xFFFF,0xBDF7,0x0000,0x0000,0x0000,0x0000,0x0000,0x0000,0x0020,0x0000,
  0x8410,0xFFFF,0xFFDF,0xFFFF,0xFFFF,0xFFDF,0xFFFF,0xBDF7,0x0000,0x0000,0x0000,0x0000,
  0x0000,0x0000,0x0020,0x0000,0x8410,0xFFFF,0xFFDF,0xFFFF,0xFFFF,0xFFFF,0xFFFF,0xBDF7,
  0x0000,0x0000,0x0000,0x0000,0x0000,0x0000,0x0020,0x0000,0x8410,0xFFFF,0xFFDF,0xFFFF,
  0xFFFF,0xFFFF,0xFFFF,0xBDF7,0x0000,0x0000,0x0000,0x0000,0x0000,0x0000,0x0020,0x0000,
  0x8410,0xFFFF,0xFFDF,0xFFFF,0xFFFF,0xFFFF,0xFFFF,0xC618,0x0000,0x0000,0x0000,0x0000,
  0x0000,0x0000,0x0000,0x2965,0xE73C,0xFFFF,0xFFFF,0xFFFF,0xFFFF,0xFFFF,0xFFFF,0xFFDF,
  0x630C,0x0000,0x0000,0x0000,0x0000,0x0000,0x0020,0xCE79,0xFFFF,0xFFFF,0xFFFF,0xFFFF,
  0xFFFF,0xFFFF,0xFFFF,0xFFFF,0xF7BE,0x2104,0x0000,0x0000,0x0000,0x0000,0x39C7,0xFFFF,
  0xFFFF,0xFFFF,0xFFFF,0xFFFF,0xFFFF,0xFFFF,0xFFFF,0xFFDF,0xFFFF,0x7BCF,0x0000,0x0020,
  0x0020,0x0000,0x7BEF,0xFFFF,0xFFDF,0xFFFF,0xFFFF,0xFFFF,0xFFFF,0xFFFF,0xFFFF,0xFFFF,
  0xFFFF,0xBDD7,0x0000,0x0000,0x0020,0x0000,0x8430,0xFFFF,0xFFDF,0xFFFF,0xFFFF,0xFFFF,
  0xFFFF,0xFFFF,0xFFFF,0xFFFF,0xFFFF,0xC618,0x0000,0x0000,0x0000,0x0000,0x4A69,0xFFFF,
  0xFFFF,0xFFFF,0xFFFF,0xFFFF,0xFFFF,0xFFFF,0xFFFF,0xFFDF,0xFFFF,0x8C71,0x0000,0x0020,
  0x0000,0x0000,0x0861,0xE73C,0xFFFF,0xFFFF,0xFFFF,0xFFFF,0xFFFF,0xFFFF,0xFFFF,0xFFDF,
  0xFFFF,0x31A6,0x0000,0x0000,0x0000,0x0000,0x0000,0x52AA,0xFFFF,0xFFFF,0xFFFF,0xFFFF,
  0xFFFF,0xFFFF,0xFFFF,0xFFFF,0x8C71,0x0000,0x0000,0x0000,0x0000,0x0000,0x0000,0x0000,
  0x630C,0xEF7D,0xFFFF,0xFFFF,0xFFFF,0xFFFF,0xFFFF,0x8C71,0x0000,0x0000,0x0000,0x0000,
  0x0000,0x0000,0x0000,0x0000,0x0000,0x2124,0x7BEF,0xC638,0xCE59,0x94B2,0x39C7,0x0000,
  0x0000,0x0000,0x0000,0x0000,
};
