tsgwiro1/TWM_Isolation_Variac/tt_esp32controller/src/system.h

// TWM Isolation Variac – Lüfter, Temperatursensor und Status-LED (#10)
// Copyright (c) 2025 Roger Widmer & Michael Tanner – MIT-Lizenz (siehe tt_esp32controller.ino)
#ifndef SYSTEM_H
#define SYSTEM_H

#include <Arduino.h>

// Stand des Filesystem-Images, vom Build in /version.json gestempelt.
// Leer, wenn die Datei fehlt oder unlesbar ist.
extern String fsVersion;
extern String fsContent;
extern bool   fsMatchesFirmware;
void loadFilesystemStamp();

extern volatile float wiperTemp;
extern volatile boolean tempSensorAvailable;

void setFanSpeed(uint8_t v);
float getTemperature();
void updateFan(float temp);
void initFAN(boolean tempSensorAvailable);
boolean initTempSensor();
// RTOS-Tasks
void sensorAndFanTask(void *parameter);
void statusLedTask(void *parameter);

#endif // SYSTEM_H
