tsgwiro1/TWM_Isolation_Variac/tt_esp32controller/src/icons.h

// TWM Isolation Variac – Icons für die TFT-Anzeige (Paket L, #36/#37)
// Copyright (c) 2025 Roger Widmer & Michael Tanner – MIT-Lizenz (siehe tt_esp32controller.ino)
//
// Die Symbole stammen aus Google "Material Symbols Outlined" und stehen unter der
// Apache License 2.0 (https://github.com/google/material-design-icons).
// Sie wurden aus dem Original-SVG auf 16 x 16 px gerastert und ins XBM-Format
// gebracht (1 Bit je Pixel, LSB zuerst, 2 Byte je Zeile) — TFT_eSPI kann keine
// Web-Fonts, deshalb liegen sie als Bitmap in der Firmware.
//
// Zeichnen mit:
//   tft.drawXBitmap(x, y, icon_wifi, ICON_W, ICON_H, TFT_WHITE, TFT_NAVY);
#ifndef ICONS_H
#define ICONS_H

#include <Arduino.h>

#define ICON_W 16
#define ICON_H 16

// "wifi" – WLAN verbunden
static const uint8_t icon_wifi[] PROGMEM = {
  0x00, 0x00, 0x00, 0x00, 0x00, 0x00, 0xf0, 0x1f,
  0xfc, 0x3f, 0x0e, 0xf8, 0x07, 0xe0, 0xe0, 0x0f,
  0xf8, 0x1f, 0x38, 0x1c, 0x00, 0x00, 0xc0, 0x01,
  0xc0, 0x03, 0x80, 0x01, 0x00, 0x00, 0x00, 0x00,
};

// "wifi_find" – eigener Konfigurations-AP aktiv
static const uint8_t icon_wifi_find[] PROGMEM = {
  0x00, 0x00, 0x00, 0x00, 0x00, 0x00, 0xf0, 0x1f,
  0x1c, 0x3e, 0x06, 0xe0, 0x07, 0xc0, 0x0e, 0x1e,
  0x1c, 0x36, 0x38, 0x32, 0x70, 0x3e, 0xe0, 0x7c,
  0xc0, 0x61, 0x80, 0x01, 0x00, 0x00, 0x00, 0x00,
};

// "device_thermostat" – vor der Temperaturanzeige
static const uint8_t icon_thermostat[] PROGMEM = {
  0x00, 0x00, 0x00, 0x01, 0xc0, 0x03, 0xc0, 0x02,
  0x40, 0x03, 0x40, 0x02, 0x40, 0x03, 0xc0, 0x03,
  0xc0, 0x03, 0xe0, 0x07, 0xe0, 0x07, 0xe0, 0x07,
  0xe0, 0x07, 0xe0, 0x07, 0xc0, 0x01, 0x00, 0x00,
};

#endif // ICONS_H
