tsgwiro1/TWM_Isolation_Variac/(commit log)

2026-06-19 Migration: ESP32-Controller, Voltmeter und Doku ins saubere Mono-Repo
    - tt_esp32controller/ (src, data, documentation, platformio.ini, partitions.csv,
    REVIEW.md, BACKLOG.md)
    - tt_voltmeter/ (Firmware + Doku)
    - documentation/ (gemeinsame Doku: Trinamic-Treiber, Modifikation Controller Print)
    - .gitignore um PlatformIO/IDE/macOS ergänzt, README mit Projektübersicht
    - Altlasten (alter STM32-Controller, CAD/Gehäuse/Messung, Arduino-IDE-Setup) nicht übernommen
    [partitions.csv]
2026-06-19 Paket A: USB-/OTA-Environments und Build-/Flash-Anleitung (#6, #7)
    - platformio.ini: gemeinsame [env]-Basis + zwei Upload-Varianten
    esp32s3_usb (USB, Erstflash/Recovery) und esp32s3_ota (WLAN, Default),
    kein Kommentar-Umschalten mehr; uploadfs für Webseiten dokumentiert
    - README: vollständige Build-/Flash-Anleitung (USB-Erstflash, OTA, uploadfs, Monitor)
    - BACKLOG: Paket A (#25, #6, #7, #8) auf erledigt gesetzt
2026-06-19 Paket A: PlatformIO-Konfig für Voltmeter (#26)
    - tt_voltmeter/platformio.ini: eigenes STM32-Projekt (ststm32,
    genericSTM32F103CB, ST-Link, Serial=USART1)
    - Quelle nach tt_voltmeter/src/ verschoben (PIO-Standardlayout)
    - Portierungsfix: extern "C"-Vorwärtsdeklaration für DMA1_Channel1_IRQHandler,
    sonst kollidiert der .ino-Auto-Prototyp mit der C-Linkage des ISR
    - Build verifiziert: Flash 32% / 128KB, RAM 18%
    - BACKLOG: #26 ergänzt und erledigt
2026-06-19 README: Build-/Flash-Anleitung für Voltmeter ergänzt
2026-06-19 Doku-Struktur: Plandateien ins Root, Controller-Doku zum Controller
    - REVIEW.md und BACKLOG.md vom Controller-Ordner ins Repo-Root verschoben
    (projektweite Plandateien, besser auffindbar); interne Verweise angepasst
    - Trinamic-Treiber-Doku und "Modifikation Controller Print" nach
    tt_esp32controller/documentation/ (gehören zum Controller)
    - leeres root documentation/ entfernt; README-Struktur aktualisiert
2026-06-19 Controller-Doku aufgeräumt: veraltete Arduino-IDE-Dokumente entfernt
    - Gelöscht (durch PlatformIO überholt): LittleFS-Uploader-Tutorial (.mhtml),
    ArduinoIDE_Board_Config.png, TFT_eSPI_Library_Settings.docx (Settings jetzt
    in platformio.ini), USB CDC.docx (IDE-Tools-Menü-Konfig obsolet)
    - USB CDC.md neu: nützlicher Teil (Build-Flags, BOOT+RESET-Download-Mode,
    Monitor) für den PlatformIO-Kontext umgeschrieben
    - README: BOOT+RESET-Hinweis im USB-Flash-Abschnitt ergänzt
2026-06-19 BACKLOG: Fortschritts-Übersicht mit Checkliste und Protokoll ergänzt
2026-06-20 Controller: WiFi.setSleep(false) für schnelleres OTA und reaktiveres Web-UI
2026-06-20 Paket B: Bugfixes & Spannungs-Limits vereinheitlicht (#1, #16, #19)
    - #1 Preset-Validierung prüft p3 statt p1; zusätzlich String((int)...,1)-
    Basis-Bug in den drei Preset-Fehlermeldungen behoben
    - #16 Kommentar in communicationTask an die 1000-ms-Schwelle angeglichen
    - #19 zentrale maxVoltageTarget() = min(kalibriertes Max, MAX_VOLTAGE_TARGET);
    Setpoint/Presets/Tasten-Speichern überall "0 ... kalibriertes Max",
    MAX_VOLTAGE_TARGET nur noch absolute Sicherheits-Obergrenze
    - CHANGELOG (V3.14) und BACKLOG (Paket B erledigt, 8/25) nachgeführt
    [tt_esp32controller.ino]
2026-06-20 Semantic Versioning eingeführt: Controller V3.2.0, Voltmeter V1.1.0
    - Controller-FW V3.14 -> V3.2.0, Voltmeter-FW V1.00 -> V1.1.0
    - Beide CHANGELOGs auf SemVer (MAJOR.MINOR.PATCH) umgestellt
    - Controller: Abschnitt zu [V3.2.0] (WiFi.setSleep + Paket B); Hinweis auf alte Tags
    - Voltmeter: [V1.1.0] in Entwicklung (Platzhalter #21), Basis [V1.0.0]
2026-06-20 Paket C #20: Simulationsmodus (Voltmeter-Streckenmodell)
    - Build-Flag SIM + Env esp32s3_sim (extends esp32s3_ota, Upload via OTA)
    - communicationTask ersetzt unter SIM die Serial1-Quelle durch
    simUpdateMeasuredVoltage(): Spannung aus Stepper-Position, lineares
    Modell + First-Order-Lag + leichte Gain/Offset-Abweichung + Rauschen
    - FW meldet sich als "(SIM)"; Warn-Banner im Log
    - README (Env-Tabelle), CHANGELOG (V3.2.0) und BACKLOG (#20, 9/25) nachgeführt
2026-06-20 Voltmeter V1.1.0: Rohwert-RMS (#21), USB-CDC-Konsole, USART1-Link
    - #21: sendRMSValue(last_rms_value) statt EMA-Wert -> ~40 ms Latenz an den
    Controller; EMA nur noch für die lokale ?live-Anzeige
    - Konsole/Menü auf native USB-CDC (USB-Port, PA11/PA12), da PA9/PA10 nicht
    herausgeführt waren; Float-printf aktiviert (nano.specs liess %f leer)
    - Daten-Link Controller<->Voltmeter von USART2 (PA2/PA3) auf USART1 (PA9/PA10)
    verlegt (TX); ermöglicht später Befehls-Link und FW-Update via ROM-Bootloader
    - Am Gerät verifiziert: Konsole, Live-Werte, Status, RMS-Empfang über PA9
2026-06-20 BACKLOG: Paket J (Voltmeter-Fernsteuerung) aufgenommen; #21 verifiziert
    - Paket J neu: #27 UART-Protokoll, #28 Menü über Link, #29 API/Web, #30 FW-Update
    via ROM-Bootloader; Routing-Entscheidung USART1 (PA9/PA10)
    - #21 als erledigt/verifiziert; Fortschritt 10/29; Protokoll ergänzt
2026-06-20 Doku: Hardware-Umbau Voltmeter-Link auf USART1 (PA9/PA10)
    - tt_voltmeter/documentation/Hardware-Umbau-USART1.md: Zweck, Pin-Belegung
    (Cross-over PA9->GPIO17 / GPIO18->PA10 + GND), USB-CDC-Konsole,
    ROM-Bootloader-Hinweis, Status (TX verifiziert, RX offen)
    - Layout-Screenshot des Prints beigelegt
2026-06-20 Paket C #18: Voltmeter-Datenfrische (Timeout-Absicherung)
    - isVoltageDataFresh() (Timeout 250 ms); Zeitstempel im communicationTask
    (deckt Real- und SIM-Pfad ab)
    - Regelung pausiert bei veralteten/fehlenden Werten (Position halten + Warnung)
    - Kalibrier-/Preset-Übernahmen aus dem Messwert blockiert (Tasten-Speichern,
    Settings-Modus min/max, /api/presets/save-Fallback -> 503)
    - API-Flags ist_fresh (/data) und voltage_fresh (/api/status)
    - CHANGELOG (V3.2.0) + BACKLOG (#18 erledigt, Paket C 3/5) nachgeführt
2026-06-20 Paket C #3: Positions-Offset in estimatePositionForVoltage() korrigiert
    - minWhiperPos-Offset ergänzt; die geschätzte Anfahrposition war bei negativem
    minWhiperPos systematisch um |minWhiperPos| zu hoch
    - CHANGELOG (V3.2.0) + BACKLOG (#3 erledigt, Paket C 4/5) nachgeführt
    [tt_esp32controller.ino]
2026-06-20 Paket C #17: Spannungsregelung neu (Vorsteuerung + gain-Korrektur + Halten)
    - PID + currenPresetState-Automat ersetzt durch RegPhase-Statemachine:
    Vorsteuerung (estimatePositionForVoltage) -> Settle -> gain-gerechte
    Einzelkorrektur (voltsPerStep, Deadband 1V, Damping 0.8, Settle 150ms,
    Klemme +/-150 Schritte) -> Drift-Trim im Halten
    - Vorsteuerung stoppt richtungsabhängig 5V vor dem Ziel (REG_FEEDFORWARD_UNDERSHOOT_V)
    -> Sollwert wird einseitig angefahren, kein Überschießen
    - REG-Taste: ein = anfahren + halten, aus = One-shot stoppen
    - nutzt isVoltageDataFresh() (#18); Anti-Windup (#2) damit hinfällig
    - am Gerät getestet und abgestimmt; CHANGELOG (V3.2.0) aktualisiert
    [tt_esp32controller.ino]
2026-06-20 Paket J #27: Bidirektionaler Befehls-Link Controller<->Voltmeter (Durchstich)
    Frame-Protokoll 0xA5 CMD LEN [payload] CHK 0xBB (Befehl) / 0xB5 ... (Antwort),
    koexistiert mit dem RMS-Stream 0xAA. Durchstich GET_VERSION am Gerät verifiziert.
    Voltmeter (V1.2.0):
    - Link von Raw-HAL auf Arduino Serial1 (USART1 TX+RX, Core-IRQ/Ringpuffer);
    ENABLE_HWSERIAL1, Konsole bleibt USB-CDC
    - Befehls-Parser + GET_VERSION-Antwort (liefert FW-String)
    Controller:
    - vereinheitlichter Serial1-Parser (RMS-Frames 0xAA + Antwort-Frames 0xB5)
    - sendVoltmeterCommand(); neue Route /api/voltmeter/version
2026-06-20 Paket J #28/#29 (Batch 1): Voltmeter-Status/Faktor/Auto-Zero über den Link
    Voltmeter: Link-Befehle GET_STATUS (Faktor/Offsets), SET_FACTOR (+EEPROM),
    RECAL (Auto-Zero, ACK vor der blockierenden Kalibrierung).
    Controller: voltmeterRequest()-Helper; API /api/voltmeter/status|factor|autozero;
    schlichtes Voltmeter-Panel in settings.html (finale UI in Paket G).
    Live-Wert kommt weiterhin über den RMS-Stream. Am Gerät verifiziert.
    Offen in #28/#29: geführte 3-Punkt-Kalibrierung.
2026-06-20 Paket J #28/#29: geführte 3-Punkt-Kalibrierung über den Link
    Voltmeter: CAL3_MEASURE (Punkt mitteln, Referenzspannung pro Punkt) und
    CAL3_FINISH (lineare Regression -> Faktor/Offset + EEPROM), measureAdcVolts-Helper.
    Controller: API /api/voltmeter/cal3/measure und /cal3/finish; Bedienfeld in
    settings.html. Referenzspannungen frei wählbar (min. 2 Punkte). Am Gerät verifiziert.
    Damit #28/#29 vollständig (Status/Faktor/Auto-Zero/3-Punkt-Kalibrierung via Web).
2026-06-20 Paket J: Voltmeter REBOOT und RESET_DEFAULTS über den Link
    Voltmeter: Link-Befehle REBOOT (NVIC_SystemReset, ACK + flush vor Reset) und
    RESET_DEFAULTS (Faktor/Offset auf Standard + EEPROM); DEFAULT_*-Konstanten.
    Controller: API /api/voltmeter/reboot und /reset-defaults + Buttons im Panel.
    Fern-Rettungsleinen vor dem Versiegeln. Am Gerät verifiziert.
    [tt_esp32controller.ino, tt_voltmeter.ino]
2026-06-20 Voltmeter: totes #define DEBUG entfernt (Cleanup)
2026-06-20 Voltmeter #30 Schritt 1: ENTER_BOOTLOADER (Sprung in ROM-System-Bootloader)
2026-06-21 #30: Voltmeter-FW-Update über Link end-to-end lauffähig
    - Voltmeter (V1.2.2): jumpToSystemBootloader gefixt (HAL_DeInit/HAL_RCC_DeInit
    vor dem Sprung, VTOR statt Remap) -> ROM-Bootloader reagiert auf den Handshake.
    - Controller: AN3155-Host nutzt Page-Erase nur der Programmpages -> letzte Flash-Page
    (emuliertes EEPROM = Kalibrierung) bleibt erhalten. Diagnose-Option skipenter + Test-Button.
    Upload mit Fortschrittsanzeige (XHR).
    - CHANGELOGs + Link-Protokoll aktualisiert.
    [tt_esp32controller.ino, tt_voltmeter.ino]
2026-06-21 #34 Spannungs-Offset + #33 FW-Version aus .bin (Paket J)
    - Voltmeter (V1.2.3): Link-Befehl SET_OFFSET (0x11, Plausi -50..50 V, EEPROM);
    Magic-Tag @@VMFW@@<FW> im Image (used + Start-Referenz) zum Auslesen der Version.
    - Controller: API /api/voltmeter/offset (Offset setzen) + /api/voltmeter/update/fileversion
    (.bin nach Magic-Tag scannen). UI: Offset-Feld; Datei-Version dauerhaft anzeigen;
    beim Update-Start Datei- vs. laufende Version vergleichen (Warnung bei identischer Version).
    - Doku: beide CHANGELOG, Link-Protokoll, BACKLOG (#33/#34 aufgenommen, 17/33, Paket J 4/7).
2026-06-28 Tools: PC-Skripte fuer automatische Spannungs-Sequenz
    Python- und PowerShell-Skript zum Anfahren der Spannungsreihe
    20/50/75/100/150/200/230 V ueber die REST-API, mit automatischer
    oder manueller (Enter) Weiterschaltung. Inkl. README.
2026-06-28 Tools: lokale Weboberflaeche fuer die Spannungs-Sequenz
    - index.html: Bedienseite (Vanilla-JS), Anzahl Spannungen 1-10 einstellbar,
    Modus auto/manuell, Strombegrenzung-/Abschalt-Optionen, Live-Ausgabe, Not-Aus
    - variac_server.py: lokaler Webserver (stdlib), startet das parametrierte Skript
    und streamt dessen Ausgabe; /api/status, /api/start, /api/poll, /api/next, /api/estop
    - variac_run.py: parametrierter, nicht-interaktiver Lauf (alle Werte via CLI).
    Nach der letzten Spannung wird in beiden Modi auf Bestaetigung gewartet,
    bevor Strombegrenzung/Abschalten wie eingestellt ausgefuehrt werden
    - README um Web-Abschnitt erweitert
2026-06-28 Tools: README - variac_run.py als eigener Abschnitt C
    variac_run.py aus dem Web-Abschnitt B herausgeloest und als eigenstaendiger
    Bedienweg C (parametrierte Kommandozeile) dokumentiert. Abschnitte mit
    A/B/C-Praefix klarer getrennt.
2026-07-03 #32 LCD-Anzeige während Voltmeter-FW-Update -> Paket J abgeschlossen (7/7)
    - Eigener LCD-Screen im displayUpdateTask: Titel, 'Variac gesperrt - Ausgang AUS',
    Fortschrittsbalken + %-Wert, Statusmeldung (Erfolg gruen / Fehler rot).
    - Bedienung (Tasten/Encoder) waehrend des Updates gesperrt; Encoder ohne Sprung nach Freigabe.
    - Ergebnis bleibt 5 s stehen (VM_UPDATE_RESULT_MS), danach kompletter Screen-Rebuild
    (Normal- oder Settings-Modus); Ausgang bleibt AUS.
    - BACKLOG: #32 verifiziert, Paket J komplett (20/33). CHANGELOG ergaenzt.
2026-07-03 Paket D: Logging thread-safe (#4) + geteilte Zustände geschützt (#5) -> V3.3.0
    - #4: logMessage() -> FreeRTOS-Queue (24) + einzelner Logger-Task (Serial, RAM-Historie,
    WebSocket, Flash-Write nur dort); Historie-Snapshot unter Mutex beim WS-Connect;
    Drop-Zaehler bei voller Queue; Logger in der Stack-Ueberwachung.
    - #5: Kalibrier-Viertupel atomar unter calibMux (Schreiber: Web-Config, calibration/save,
    Settings-Modus; Leser via getCalibration()-Snapshot); whiperPos-RMW + stepper.moveTo()/run()
    unter stepperMux (setWhiperMove() als gemeinsamer Kern). 32-bit-Skalare bewusst volatile-only.
    - Version: Controller V3.3.0; CHANGELOG V3.2.0 abgeschlossen (2026-06-21).
    - BACKLOG: Paket D veri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
2026-07-03 BACKLOG: Neues Paket K (#35) - Konfiguration/Kalibrierung ins NVS, eingeplant zwischen F und G
2026-07-03 BACKLOG: #22 erweitert um REST-Konventionen, OpenAPI-Spec und Doku-Seite (Paket E, M->L); #12 entsprechend verschlankt
2026-07-04 #22 API nach REST-Konventionen + OpenAPI-Doku -> V4.0.0 (Breaking Change, Paket E)
    - Alle zustandsaendernden Routen GET->POST (setpoint, command, reboot, calibration,
    voltmeter/*); Parameter als Query-String. GET liest nur noch.
    - /data entfernt -> in GET /api/status aufgegangen (states.p1_on..p3_on ergaenzt).
    - Entfernt (ungenutzt): GET /api/presets, /api/presets/save, GET /api/calibration.
    - calibration/save -> POST /api/calibration; files/delete -> DELETE /api/files?filename=.
    - script.js/settings.js auf neue Methoden/Routen umgestellt.
    - Neu: openapi.yaml (komplette Spec, Single Source of Truth) + interaktive RapiDoc-Doku
    unter doc_api.html (lokal im LittleFS, 843 KB) - ersetzt die a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
    [openapi.yaml, tt_esp32controller.ino]
2026-07-05 Paket F #14: Migration auf ArduinoJson v7
    - StaticJsonDocument -> JsonDocument, containsKey() -> isNull()-Idiom,
    createNestedObject() -> to<JsonObject>()/add<JsonObject>(); lib_deps ^7.0.0.
    - Nebenbei: volatile++-Deprecation-Warnung im Logger bereinigt.
    - Keine Verhaltens-/API-Aenderung; OTA- und SIM-Build kompilieren.
2026-07-05 Paket F #10+#15: Modularisierung + Wiper-Renames -> V4.1.0
    - .ino 3363 -> 414 Zeilen (nur noch setup()/loop()); 11 Module je .h/.cpp:
    pins, state, logging, config, motor, comm, display, actions, web, system, sim.
    - Interna gekapselt: loggingInit(), logHistorySnapshot(), configRawJson(), initStepper();
    Parser-/AN3155-/Screen-Interna static in den Modulen.
    - #15: Whiper -> Wiper in allen internen Bezeichnern (77 Stellen, keine API-/JSON-Keys).
    - Reine Verschiebung: Verhalten/API unveraendert, RAM/Flash praktisch identisch (+1,2 KB).
    - Version: Controller V4.1.0 (V4.0.0 im CHANGELOG abgeschlossen, Tag v4.0.0 auf 71e4bdb);
    openapi.yaml bleibt bewusst auf API-Version 4.0.0. Testanleitung ak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
2026-07-05 Paket F #9 vorbereitet: 16-MB-Partitionstabelle + Umstiegs-Doku (noch nicht aktiv)
    - partitions_16mb.csv: LittleFS 2 MB -> ~9,9 MB; NVS/otadata/app0/app1 an identischen
    Offsets -> Konfiguration und Firmware ueberleben den Umstieg. Label bleibt bewusst
    'spiffs' (Transitionssicherheit: ein Binary fuer alte UND neue Tabelle).
    - documentation/Partitionierung-16MB.md: Motivation, Warum-nicht-OTA, Umstiegs-Prozedur
    (USB-Flash am Geraet), Rollback.
    - platformio.ini: auskommentierte Umschaltzeile; aktive partitions.csv unveraendert,
    OTA-/uploadfs-Builds bauen weiter gegen das reale Geraetelayout.
    - BACKLOG: #9 'vorbereitet'; Paket F damit code-seitig komplett (Tests/USB-Flash offen).
    [partitions_16mb.csv]
2026-07-05 Doku: Testanleitung um T3a (#31 Regelparameter) ergaenzt, #9-Prozedur als Checkliste (U1-U7)
    - Testanleitung deckt jetzt explizit V3.3.0 -> V4.1.0 ab (T3a schliesst die #31-Luecke).
    - Partitionierung-16MB.md: Schritt-fuer-Schritt-Checkliste inkl. NVS-Verifikation und
    Aufraeum-Schritt U7.
    - Beide Dokumente als temporaer markiert (werden nach Test bzw. #9-Umsetzung entfernt).
2026-07-12 Testlauf-Fixes: openapi.yaml YAML-Syntax repariert (GitHub-#5), Doku Kalibrier-Reihenfolge + veraltete Einstellungs-Doku aktualisiert (GitHub-#4)
    [openapi.yaml]
2026-07-12 GitHub-#3: Kalibrier-Einstieg mit Homing-Referenzfahrt, sichere P1/P2-Anfahrten (geklemmt + ausserhalb 0..2000 gedrosselt), Voltmeter-Plausibilitätswarnung beim Speichern
2026-07-12 Tools: GitHub-#6 Messung erst bei erreichter Spannung (Polling ±2V/30s), GitHub-#7 Sequenz wahlweise ohne Strombegrenzung (--limit-off + UI-Checkbox + Abfrage), GitHub-#8 Not-Aus ohne Sicherheitsabfr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
2026-07-12 Tools: Messwert erst nach Ausregelung ausgeben (Stabilitätskriterium ±0.5V), Schlussfrage Strombegrenzung nur wenn sie eingeschaltet ist (Nachtrag zu GitHub-#6/#7)
2026-07-13 Ansteuerung Fan korrigiert auf die neue LEDC-API
    ledcWrite(PIN_FANPWM, dutyCycle) statt ledcWrite(FAN_PWM_CHANNEL, dutyCycle), so dass die neue LEDC-API verwendet wird
    [system.cpp]
2026-07-18 Paket G: Web-Oberfläche komplett neu nach Claude-Design (#23) + Live-Status über WebSocket /ws_status (#13), V4.2.0
    - Dashboard/Settings/Log/Doku-Seiten als Vanilla-Nachbau des Design-Entwurfs
    - app.css/app.js als gemeinsames Design-System: Dark/Light + Akzentfarbe umschaltbar (Default teal), Fonts lokal (WOFF2, offline-fähig)
    - Neu: Spannungsverlauf-Chart, Konfig-Backup/Restore, Log-Download; BOOT0-Button entfällt
    - RapiDoc wird live aus den Design-Tokens eingefärbt; style.css abgelöst und entfernt
    - Firmware: /ws_status pusht Status alle 500ms (eine JSON-Quelle mit /api/status), Dashboard mit Polling-Fallback
2026-07-18 Bugfix: Presets überleben jetzt die Endpunkt-Kalibrierung - saveConfiguration übernimmt sie im Setup-Modus aus dem NVS statt 0/0/0 zu schreiben
    [config.cpp]
2026-07-19 V4.2.1: 16-MB-Partitionierung aktiv (#9) - per USB geflasht, NVS überlebte, OTA verifiziert; partitions.csv konsolidiert, Umstiegs-Doku entfernt, Paket F komplett (31/34)
    [partitions.csv, partitions_16mb.csv]
2026-07-19 BACKLOG.md: Fortschrittstabelle aktualisiert (E, F, G erledigt)
    Pakete E (API-Vereinfachung), F (Struktur & Modernisierung) und G (Web-Oberfläche)
    waren in der Checkliste bereits als erledigt markiert, die Fortschrittstabelle oben
    reflektierte das aber nicht. Tabelle aktualisiert zu 31/34 Gesamt.
2026-07-19 V4.3.0: Doku konsolidiert und vervollständigt (Paket I, #24 + #12)
    Alt-Doku abgeräumt (ohne Informationsverlust):
    - 4 veraltete docx gelöscht: REST-API V3.11, Kalibrieranleitung V3.11,
    Status-LED, Voltmeter-Designnotizen (Messprinzip ist im Quellcode kommentiert)
    - Status-LED komplett in doc_usage.html übernommen + neu als
    documentation/Status-LED.md (gegen statusLedTask verifiziert)
    - Software-Kalibrierung als "Methode 2" in doc_settings.html
    Geräte-Doku vervollständigt (Review Roger):
    - LED-Verhalten Encoder-Taste (an = x10) und Preset-Tasten dokumentiert
    - Einstellungs-Doku: vollständige Feldreferenz aller GUI-Abschnitte +
    Voltmeter-Abschnitt (Status, manuelle/3-Punkt-Kalibr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
2026-07-19 V4.3.1: Mobile-Fixes für die Web-Oberfläche
    - Einstellungsseite: Status-Grid im Voltmeter-Panel lief auf schmalen
    Displays über den Panel-Rand (Grid-Spalten schrumpfen nicht unter die
    Inhaltsbreite) — neue Klasse .kv-grid mit minmax(0,1fr), unter 560 px
    einspaltig; .kv-Zellen dürfen umbrechen
    - Navigation: Mobile Browser (iOS/iPadOS und Android) können per Script
    nicht zuverlässig zwischen Tabs wechseln — auf Mobilgeräten navigieren
    die Header-Icons jetzt im selben Tab (IS_MOBILE-Erkennung); benannte
    Tabs bleiben ein Desktop-Feature
    - Am iPhone verifiziert (Layout + Navigation)
    [state.h]
2026-07-19 Paket-H-Plan + Testanleitung V4.3.1 (Gesamtabnahme)
    - Paket-H-Plan.md: Umsetzungsplan für #11 Sicherheit (Blöcke A-D: OTA-/AP-Passwort,
    HTTP-Basic-Auth mit NVS-Passwort, Tools, Doku; ~1 Arbeitstag). Nutzen/Grenzen
    (kein HTTPS, Aussperr-Risiko, WebSockets offen) und offene Entscheidungen
    dokumentiert - Umsetzung zu einem späteren Zeitpunkt
    - Testanleitung-V4.3.1.md: aufbauende Gesamtabnahme Controller V4.3.1 +
    Voltmeter V1.2.3, durchnummeriert T0-T15 für eindeutige Issue-Zuordnung;
    deckt Bedienung/LEDs, Regelung, Web/Mobile, Kalibrierung (beide Methoden),
    Voltmeter-Panel + FW-Update, Log, API, Doku, OTA und Tools ab (inkl.
    Retests GitHub-#6/#7 als T15.1/T15.2, ps1 auf Window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
2026-07-21 One-Pager fürs Messe-Auflegen (technisches Datenblatt)
    A4, eine Seite: Kurzbeschreibung, Architektur (Controller/Voltmeter),
    Bedienung & Technik im Überblick, Kennzahlen (Spannungsbereich, Update-Rate,
    Presets, Lizenz), Footer mit Projektteam + QR-Code zum GitHub-Repo.
2026-07-23 Checkliste für Michael: 16-MB-Partitionierung per USB nachziehen
    Michaels Gerät hat noch die alte 2-MB-Filesystem-Partition, daher passt das
    neue ~10,4-MB-LittleFS-Image nicht (uploadfs schlägt fehl). Die Partitionstabelle
    (0x8000) kann nur per USB geflasht werden. Anleitung: Config-Backup als
    Sicherheitsnetz, USB-Upload (Tabelle+Firmware) + uploadfs, Verifikation.
    NVS/Kalibrierung bleibt erhalten (identische Offsets, kein Erase). Temporäres
    Dokument, wird nach dem Umstieg wieder entfernt.
2026-07-23 V4.4.0: Boot-Hänger behoben (#13/#11), Temperatur-Schwellen angeglichen (#20)
    Das Gerät startete sporadisch nicht (Display schwarz, Tasten tot, Lüfter 100 %),
    weil wm.autoConnect() vor der gesamten Hardware-Init lief und das Config-Portal
    bis zu 10 Minuten blockierte. WLAN, Webserver und OTA laufen jetzt in einem
    eigenen networkTask, der erst nach Hardware-Init und Homing startet.
    Verhalten ohne WLAN: ein Verbindungsversuch, dann Config-Portal; nach dessen
    Timeout wird das Funkmodul abgeschaltet und der Variac läuft ohne Web/API
    weiter. Neuer Versuch erst nach Neustart.
    Ausserdem: Dashboard-Temperaturschwellen folgen der Firmware (60/70 statt
    70/90 °C), STATE_WIFI_CONNECTING heisst je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
    [display.cpp, state.cpp, state.h, system.cpp, tt_esp32controller.ino]
2026-07-23 Paket L (LCD-Optimierung) aufgenommen: #36 WLAN-Icon, #37 Temperaturanzeige
    Sammelpaket für Verbesserungen an der Geräteanzeige; weitere Punkte kommen
    voraussichtlich dazu. Plan in Paket-L-LCD-Optimierung.md mit Kopfzeilen-Layout
    (WLAN-Icon links, Titel neu zentriert, Temperatur rechts), Weg für die Icons
    (Material Symbols als XBM, da TFT_eSPI keine Web-Fonts kann) und offenen Punkten.
    BACKLOG: Paket L in Fortschrittstabelle, Checkliste, Paket-Reihenfolge und
    eigenem Detailabschnitt; Gesamtzahl 33/36. Protokolleintrag zu V4.4.0 ergänzt.
2026-07-23 V4.5.0: Paket L umgesetzt - WLAN-Icon und Temperaturanzeige auf dem TFT (#36/#37)
    Kopfzeile neu aufgeteilt: WLAN-Status als Icon links (verbunden / eigener
    Config-AP / kein Symbol), Titel zentriert, Temperatur rechts mit
    Thermometer-Icon, ohne Nachkommastellen und mit Gradzeichen.
    Die Symbole stammen aus Google Material Symbols (Apache 2.0) und liegen als
    XBM-Bitmaps in der neuen src/icons.h (16x16 px, zusammen 96 Byte) - TFT_eSPI
    kann keine Web-Fonts darstellen. Das Gradzeichen wird als Kreis gezeichnet,
    weil Font 2 nur ASCII 32..127 abdeckt.
    Passt eine breitere Temperaturgruppe (dreistellig oder N/A) nicht in den
    reservierten Bereich, entfaellt das Icon - der Messwert hat Vorrang und der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
2026-07-23 V4.5.1: Android-Darstellungsfehler behoben (#16), totes Fan-Define entfernt (#21)
    Dashboard war auf schmalen Displays breiter als der Viewport (bei 360 px
    gemessen: 430 px, waagrechte Laufleiste). Ursache: grid-template-columns: 1fr
    beim Dashboard-Grid - 1fr ist minmax(auto,1fr) und laesst die Spalte nicht
    unter die Mindestbreite ihrer Inhalte schrumpfen. Mit minmax(0,1fr) faellt die
    Spalte auf 316 px, die Seite bleibt im Viewport. Gleiches Muster wie der
    .kv-grid-Fix aus V4.3.1; die Desktop-Regel ab 880 px gleich mit abgesichert.
    Live-Log war unten abgeschnitten: 100vh ist auf Mobilgeraeten groesser als der
    sichtbare Bereich, zusammen mit overflow:hidden waren die neuesten Meldungen
    unerre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
    [state.h, system.cpp]
2026-07-23 V4.5.2: Ueberlagerte Anzeige beim Kalibrier-Einstieg ueber die API behoben (#18)
    Waehrend der Homing-Referenzfahrt legte sich der Settings-Screen ueber den
    "Homing..."-Bildschirm. Ursache war ein Zeitfenster in actions.cpp:
    currentMode wechselte bereits auf MODE_SETTINGS, waehrend das bisherige
    Schutzflag (stepperPaused, abgefragt ueber isHomingActive()) erst in homing()
    selbst gesetzt wird. Dazwischen sah der displayUpdateTask auf Core 0 einen
    Settings-Modus ohne laufendes Homing und zeichnete darueber. Ueber die Taste am
    Geraet trat der Fehler nicht auf, weil dort die RTOS-Tasks noch nicht laufen.
    Neues Anzeige-Flag homingScreenActive statt Eingriff ins Stepper-Flag: gesetzt
    vor dem Modus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
    [actions.cpp, display.cpp, state.cpp, state.h]
2026-07-24 V4.5.3: statusLedTask gehaertet, wirkungslose Serial-Warteschleife entfernt (#14)
    Punkt 1: statusLedTask-Stack von 1024 auf 2048 Byte erhoeht und Handle vergeben,
    damit der Task in der Stack-Ueberwachung in loop() mitlaeuft. Auf Core 0 laufen
    Interrupts (WLAN u.a.) auf dem Stack des aktiven Tasks - 1024 war dafuer knapp,
    und ohne Handle fehlte jede Sichtbarkeit auf den realen Verbrauch.
    Punkt 2: die while(!Serial && ...)-Schleife in setup() hatte eine invertierte
    Bedingung und wartete nie. Ersatzlos entfernt statt "repariert": Serial ist die
    USB-CDC-Konsole, die im Standalone-Betrieb (kein USB-Kabel) nie verbindet - ein
    echtes Warten wuerde jeden Boot um den vollen Timeout verzoegern, das G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
2026-07-24 V4.5.4: Web-Block #15/#17/#19/#22 (Presets live, Menü-Position, Voltmeter-Meldungen)
    #15 Preset-Werte live: der 500-ms-Status-Push traegt jetzt die Preset-Werte mit
    (presets in /api/status). Dashboard und Einstellungsseite folgen live ueber
    /ws_status; die Einstellungsseite (bekam dafuer denselben Stream) aktualisiert
    die Preset-Felder nur bei sauberem Formular und nie das fokussierte Feld, plus
    Tab-Wechsel-Abgleich als Fallback.
    #17 Fly-out-Menue: Akzentfarbe-/Doku-Menue klappten immer nach links auf und
    lagen auf schmalen Displays teils ausserhalb des Sichtbereichs. positionMenu()
    schiebt sie nach dem Oeffnen in den sichtbaren Bereich (8 px Rand).
    #19 Voltmeter-Link-Fehler: loadVoltmete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
2026-07-24 Display-Redesign: 3 Layout-Mockups + Erklaerung (WIP)
    Diskussionsgrundlage fuer das TFT-Redesign (240x320): drei Layout-
    Varianten als massstabsgetreue SVGs, README mit Farb-/Icon-Logik und
    offenen Fragen. Temporaerer WIP-Ordner - am Ende bleibt nur das finale
    Mockup, der Rest wird abgeraeumt.
2026-07-24 Display-Mockups: Ausgang rot, Thermometer-Kontur, groesserer Blitz
    - Ausgang-Anzeige in Rot (passend zum roten Taster) statt Blau (B/C)
    - Thermometer-Icon nur als Kontur, ohne Fuellanzeige; Position in A/B
    korrigiert (ueberlappte die Temperaturzahl)
    - Blitz im gelben Warndreieck vergroessert
2026-07-25 V4.6.0: Logging ueberarbeitet - Datei entspricht wieder dem Live-Log (#23)
    Die heruntergeladene Logdatei bestand zu ~92 % aus "N Meldung(en) verworfen"-
    Zeilen. Ursache war ein sich selbst verstaerkender Zyklus: Bei voller Queue gab
    der Logger nach jedem Eintrag eine solche WARN-Meldung aus, die selbst in den
    Flash geschrieben wurde und den Task weiter ausbremste. Diese Meldungen sind
    entfernt; verworfene Eintraege werden nur noch still gezaehlt (log_dropped).
    Die Datei enthaelt jetzt alle Level statt nur WARN+ und entspricht damit dem
    Live-Log (sie ueberdauert zusaetzlich Neustarts). Geschrieben wird gepuffert:
    WARN+ sofort (ueberlebt einen Absturz), INFO gesammelt und alle 100 Zeilen bzw.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
2026-07-25 V4.6.1: Zeiger-Drehung und API-Doku auf schmalen Bildschirmen (#24/#25), Doku-Abgleich
    #24 - Der Zeiger der Spannungsanzeige loeste sich in Chrome/Edge bei groesseren
    Spruengen vom Drehpunkt, wanderte quer ueber das Zifferblatt und rastete erst am
    Ende wieder ein (Safari unauffaellig). Ursache war die CSS-Transition auf dem
    SVG-Attribut transform="rotate(a 120 120)": Das Drehzentrum steckt dort im
    animierten Wert, beim Interpolieren entsteht daraus ein Translationsanteil, den
    Blink linear von Start- nach Endwert zieht - der Drehpunkt nimmt die Sehne statt
    des Kreisbogens.
    Wie eine Drehung interpoliert wird, handhaben die Engines generell verschieden:
    Der Zwischenschritt ueber transform-orig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
2026-07-25 Bugfix-Runde aus dem V4.3.1-Testlauf protokolliert; Testanleitung entfernt
    Die 13 GitHub-Issues des Testlaufs (#13-#25) sind umgesetzt und am Geraet
    abgenommen, verteilt auf V4.4.0 bis V4.6.1. Der BACKLOG-Protokolleintrag haelt
    fest, was in welcher Version steckt und warum. Offen bleiben aus dem Testlauf
    nur die Tools-Nachtests #6/#7 bei Michael.
    documentation/Testanleitung-V4.3.1.md geloescht - Zweck erfuellt, die Historie
    behaelt die Datei.
2026-07-25 V4.7.0: Variac waehrend Updates gesperrt, definierter Grundzustand (#26)
    Laeuft ein OTA-Update (Firmware oder Filesystem), ist der Variac jetzt gesperrt:
    keine Eingaben ueber Tasten/Encoder, Webseite oder API. Vorher lief waehrend des
    Updates alles unveraendert weiter - der Ausgang blieb unter Spannung, und selbst
    ein POST /api/reboot oder ein Dateiloeschen mitten im Filesystem-Upload wurde
    ausgefuehrt.
    Gemeinsame Sperre controlsLocked() = OTA laeuft oder Voltmeter-FW-Update laeuft,
    ausgewertet an drei Stellen: userInputTask (Tasten/Encoder), Webserver (alle
    zustandsaendernden Routen antworten 503, lesende bleiben offen) und
    displayUpdateTask (eigener Screen). Damit ist auch die bestehende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
    [actions.cpp, actions.h, comm.cpp, display.cpp, display.h, motor.cpp, motor.h, openapi.yaml]
2026-07-25 Display-Redesign: Hinweis auf die weiteren Vollbild-Screens
    Die Mockups zeigen den Normalbetrieb. Das Display kennt aber noch fuenf weitere
    Vollbild-Screens (Einstellungen, Referenzfahrt, Systemfehler, Voltmeter-Update
    und - neu seit V4.7.0 - das OTA-Update). Werden die beim Redesign uebersehen,
    stehen sie hinterher stilistisch neben dem neuen Hauptlayout.
    Tabelle mit Funktion und Inhalt je Screen ergaenzt, dazu der Hinweis auf
    forceSafeState() aus V4.7.0: Beim Sperren wird ein definierter Zustand
    hergestellt (Ausgang aus, Strombegrenzung ein, Regelung aus, Preset- und
    x10-LED aus), den die neue Statusdarstellung eindeutig zeigen koennen sollte.
2026-07-28 Display-Redesign: neuer Normalbetrieb-Screen (Zwischenstand)
    Normalbetrieb komplett neu gestaltet (am Gerät iteriert):
    - Ist/Ziel gestapelt, rechtsbuendig; Ist gross/fett/farbcodiert
    (gelb=Limit ein, rot=Limit aus, hellgrau=Ausgang aus), Ziel gleich
    gross aber grau und nicht fett.
    - Zwei Warndreiecke in eigener linker Spalte (Achtung / >50 V), aktiv
    pulsierend (Farbe<->dim), sonst dim-grau; Achtung unabhaengig vom
    Ausgang (nur Strombegrenzung).
    - Drei Schalter-Chips (Ausgang/Limit/Regelung) als Symbol, leuchtet=EIN;
    Regelung = Schloss (konsistent mit Preset-Schloss).
    - Presets folgen dem Zielwert (blau auch bei Ausgang aus).
    - Glatte Vektor-FreeFonts, Kopfzeile WLAN + Temperatur,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
    [display.cpp]
2026-07-29 Display-Redesign: Rückmeldung zum Zwischenstand ergänzt
    Feedback-Roger-2026-07-29.md: Rückmeldung nach dem Gerätetest von 982ce97.
    Gesamteindruck positiv; Vorschläge zum Feinschliff in drei Blöcken
    (Spannungsblock, Warnungen, Gliederung) mit jeweiliger Begründung, plus
    die Beobachtung, dass die grossen Zahlen flackern (Vorschlag: Sprite-
    Double-Buffering statt löschen/neu zeichnen).
2026-08-03 Display-Redesign Beta 2: Rahmen-Layout + Feinschliff
    - Ist/Ziel rechtsbuendig ohne Labels; Ist gross/fett/farbig, Ziel
    kleiner, grau und nicht fett.
    - Rahmen (Radius wie Chips, an den aeusseren Chips ausgerichtet) um
    Werte + Warnfeld; kein Presets-Text.
    - Nur noch ein gelbes Achtung-Dreieck (schwarzes !), abgerundete
    Ecken, erscheint nur bei Strombegrenzung AUS, hartes Blinken;
    >50-V-Warnung entfernt.
    - Double-Buffering (TFT_eSprite) fuer Ist/Ziel gegen Flackern.
    - WLAN-Symbol groesser (drawSmoothArc), neues teilgefuelltes
    Thermometer-Icon, groessere Temperaturschrift.
    Mockups (display-redesign) + README auf Beta-2-Stand nachgezogen.
    [display.cpp]
2026-08-05 Display-Redesign (V4.8.0): Regelabweichungsbalken, eigener Font, generierte Icons
    - Normalbetrieb-Screen neu: grosse farbcodierte Ist-Spannung mit eigenem Font
    (font_volt56, Arial-Bold @56px, Ziffern 41px), Regelabweichungsbalken statt
    Zielspannungs-Zeile (Variante A/B per Langdruck Regelungstaste, displayVariant
    im NVS und /api/config), immer sichtbares Warndreieck, Rahmen, 3 Chips,
    3 Presets (Blau nur bei explizitem Aufruf).
    - Warndreieck und Thermometer als generierte Anti-Aliasing-Bitmaps
    (warn_icon.h / thermo_icon.h, pushImage mit setSwapBytes) statt Zeichenprimitive.
    - Flackerfrei via Sprites: Ist-Spannung, Balken und Temperatur-Kopfzeile.
    - OTA-Rollback-Fix: setup() bestaeti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
    [actions.cpp, config.cpp, display.cpp, state.cpp, state.h, thermo_icon.h, tt_esp32controller.ino, warn_icon.h]
2026-08-05 Regelung: Web/API-Pfad fuehrt jetzt nach (GitHub-#27, V4.8.1)
    Ueber das Dashboard bzw. POST /api/command?action=toggle_regulation
    eingeschaltete Regelung schaltete nur die LED, ohne den Feedforward
    anzustossen: ein nach dem Preset entstandener Lastabfall blieb
    unkorrigiert. Ursache war ein reines A_reg->toggle() ohne isRecallPreset
    -- dadurch bleibt is_regulation_active false und motorControlTask
    verlaesst RP_IDLE nie. Die Gerraetetaste war seit V4.8.0 bereits korrekt.
    Fix: gemeinsame Funktion toggleRegulation() (actions.cpp), die
    Geraetetaste UND Web/API benutzen -- beide Wege stossen jetzt identisch
    die Anfahrt auf den Sollwert an und raeumen beim Ausschalten auf.
    Am Geraet verifiziert: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
    [actions.cpp, actions.h, state.h, web.cpp]
2026-08-06 Backlog und Paketpläne auf den Stand V4.8.1 gebracht
    Alle GitHub-Issues sind geschlossen (auch die Tools-Nachtests #6/#7), der
    aktuelle Release ist V4.8.1. Der Backlog kannte das Display-Redesign bisher
    gar nicht, weil es über einen Feature-Branch statt über die Backlog-
    Nummerierung lief: neu als Paket M (#38) aufgenommen und als erledigt
    gefuehrt, Zaehlung damit 36/37. Dazu ein Protokolleintrag zu V4.8.0
    (Display-Redesign) und V4.8.1 (GitHub-#27, Regelung ueber Web/API fuehrt nach).
    Paket-H-Plan nannte als Zielversion noch V4.8.0 - diese Nummer ist inzwischen
    vergeben, korrigiert auf V4.9.0. Paket L ist geschlossen: die weitergehende
    Anzeigen-Arbeit ist in Paket M aufgegangen.
    REVIEW.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
2026-08-14 Tools: Messe-Demo variac_demo.py
    Unbeaufsichtigte Vorfuehrung fuer den Messestand: Endlosschleife aus vier
    Phasen je Durchlauf - Hochlauf in Stufen (15/35/60/85/100 % der Obergrenze),
    Presets per Direktwahl, Feinregelung mit kleinen Sollwertspruengen, Rueckfahrt
    auf 0 V. Keine Rueckfragen, Beenden mit Strg+C. Der REST-Client wird aus
    variac_sequence.py importiert, nicht dupliziert.
    Fuer den Dauerbetrieb abgesichert: harte Obergrenze 230 V im Code (--max nur
    darunter), Presets oberhalb der Grenze werden uebersprungen, Temperaturwaechter
    (ab 50 C pausieren bis 45 C, ab 58 C abbrechen), Wiederholungen bei
    Netzfehlern, Warten statt Befehlsverlust bei HTTP 503 (Bediensperre seit
    V4.7.0) und in j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
2026-08-14 Tools: variac_demo.py zeigt ohne Parameter die Hilfe
    Ein Aufruf ohne Argumente startete bisher sofort die Vorfuehrung und schaltete
    den Ausgang ein. Jetzt gibt das Skript in diesem Fall nur seine Hilfe aus und
    schaltet nichts; fuer den Start ist mindestens --host noetig.
    Die Hilfe beschreibt zusaetzlich den Ablauf der vier Phasen, drei
    Beispielaufrufe (Endlosdemo, ruhigerer Ablauf, Probelauf mit --dry-run) und die
    Sicherheitshinweise. Die genannten Grenzwerte werden aus den Konstanten
    formatiert, damit Text und Verhalten nicht auseinanderlaufen.
2026-09-13 Hardware-Dokumentation ins Repo, Print-Modifikationen als eigene Dokumente
    Neuer Ordner Hardware/ mit Stückliste und Verdrahtung des Geräts, dazu Schema,
    Layout, Gerber und BOM der vier Prints, Datenblätter, CAD-Modelle, 28
    aufbereitete Fotos und drei schematische Zeichnungen.
    Die Verdrahtung ist nach Ort im Gerät gegliedert — Rückplatte, Frontplatte,
    Dazwischen — und unterscheidet zwei Detailtiefen: die 230-V-Seite Litze für
    Litze mit Aderfarbe und Querschnitt, die Niedervolt-Seite nur mit Stecker,
    Polzahl und Funktion. Ein Übersichtsschema mit 16 nummerierten Stationen
    verbindet Zeichnung und Tabellen.
    Die drei Modifikationen an den Prints liegen neu als eigene Dokumente vor: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
    [AC_Voltmeter_Case v7.step, BOM_Trennstelltrafo-Power_2026-09-13.csv, BOM_Trennstelltrafo_2026-09-13.csv, BOM_Trenntrafo_AC_Voltmeter_2026-09-13.csv, BOM_Trenntrafo_ESP32_2026-09-13.csv, Stepper Mount v50.step]
2026-09-13 README: Versionsstand und OnePager verlinkt, Voltmeter V1.2.3 abgeschlossen
    Das README nennt neu den Stand beider Firmwares — Controller V4.8.1 und
    Voltmeter V1.2.3 — und verlinkt den bisher nirgends erwähnten OnePager.
    Voltmeter V1.2.3 ist abgeschlossen und im CHANGELOG datiert; die Version stand
    im Code (#define FW) bereits, der Eintrag war noch als "in Entwicklung"
    markiert. Getaggt als voltmeter-v1.2.3 — mit Präfix, weil die bestehenden Tags
    v4.x ausschliesslich den Controller bezeichnen.
2026-09-13 OTA: uploadfs bricht nicht mehr vorzeitig ab
    Der Standardwert von espota für "Timeout to wait for the ESP32 to accept
    invitation" liegt bei 10 Sekunden. Das LittleFS-Image ist rund 10 MB gross, und
    der ESP löscht die Partition, bevor er die Einladung annimmt — das dauert
    länger. 'pio run -t uploadfs' schlug deshalb mit "timed out" fehl, noch bevor
    die Übertragung begann, und das Gerät startete anschliessend per Watchdog neu.
    upload_flags setzt den Timeout auf 90 Sekunden. Das Environment esp32s3_sim
    erbt von esp32s3_ota und ist damit ebenfalls abgedeckt. Der Hinweis zum
    optionalen OTA-Passwort steht jetzt als einkommentierbare Zeile in derselben
    Liste; das README ist entsprechend ang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
2026-09-13 V4.8.2: Firmware und Filesystem tragen denselben Versionsstempel
    Beide Artefakte werden getrennt geflasht und konnten unbemerkt auseinanderlaufen.
    Eine Änderung an data/ war von aussen nicht erkennbar, weil die Versionsnummer
    allein in der Firmware stand — genau so ist der Haftungsausschluss in
    doc_usage.html auf das Gerät gelangt, ohne dass sich an der Version etwas zeigte.
    Die Nummer liegt jetzt in version.txt, der einzigen Stelle, an der sie gepflegt
    wird. scripts/version.py läuft als Pre-Build-Hook, reicht sie als FW_VERSION an
    den Compiler und legt sie zusammen mit einem Inhalts-Hash über data/ als
    /version.json ins Filesystem-Image. Ändert sich data/, ohne dass die Version
    stei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
2026-09-13 Prüfung nach dem Upload: entspricht das Gerät dem Stand im Repo?
    Das Gerät erkennt seit V4.8.2, wenn Firmware und Filesystem auseinanderlaufen.
    Den anderen Fall kann es nicht sehen: Wurde ein Upload ganz vergessen, sind beide
    Artefakte alt und damit in sich stimmig — nur der Build-Rechner weiss, dass es
    einen neueren Stand gibt, weil ihm beide Seiten vorliegen.
    scripts/check_device.py hängt sich hinter 'upload' und 'uploadfs', holt
    /api/status und vergleicht mit data/version.json, das der Pre-Hook im selben Build
    geschrieben hat. Dadurch wird der Hash an genau einer Stelle berechnet und die
    beiden Skripte können nicht auseinanderlaufen.
    Die Prüfung ist eine Zugabe, kein Tor. Ein ge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
2026-09-13 BACKLOG: Stand vom 13.09. nachgetragen
    Protokolleintrag über die Hardware-Dokumentation, den Versionsstempel für
    Firmware und Filesystem (V4.8.2), den behobenen uploadfs-Abbruch, die
    Aufräumarbeiten im Repo und den ersten Voltmeter-Tag. Die Stand-Zeile nennt
    jetzt V4.8.2.
    Die Paketübersicht bleibt unverändert: H ist weiterhin das einzige offene
    Paket. Die Arbeit von heute war ungeplante Pflege und bekommt deshalb keine
    eigenen IDs — dafür ist das Protokoll da.
2026-09-13 V4.8.3: WLAN-Portal repariert (GitHub-#29, #30)
    #30: Im Config-Portal startete der Controller neu, meist während der
    Passworteingabe. Ursache war der Task-Watchdog, nicht der Portal-Timeout:
    Der WiFiManager dreht seine blockierende Schleife nur mit yield(); hält ein
    Handy eine Verbindung offen, ohne zu senden, kommt der Idle-Task auf Core 0
    bis zu 5 s nicht zum Zug. Das Portal läuft jetzt nicht blockierend in einer
    eigenen Schleife mit vTaskDelay.
    #29: Nach dem Speichern eines neuen WLANs blieben Webseite und API bis zum
    Aus- und Einschalten tot. Der Controller startet nach dem Speichern jetzt
    kontrolliert neu (sicherer Zustand, Log gesichert, Dateisystem geschlossen).
    Beides am Gerät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
2026-09-14 V4.9.0: Hostname konfigurierbar (GitHub-#28)
    Der Name für DHCP und mDNS war fest im Code. Er steht jetzt als
    network.hostname in der Konfiguration (NVS), ist auf der Einstellungsseite
    im neuen Abschnitt "Netzwerk" änderbar und gilt nach einem Neustart.
    Validierung nach RFC 1123 (1-63 Zeichen a-z, 0-9, '-').
    Standard neu twm-variac statt twm_variac: Der Unterstrich ist als Hostname
    nicht normgerecht. upload_port, README und Doku nachgezogen.
    /api/status liefert den aktiven Namen als hostname; weicht er vom
    gespeicherten ab, meldet die Einstellungsseite "Neustart nötig".
    API-Version 4.5.0, Status-Schema um die fehlenden fs_*-Felder ergänzt.
    Am Gerät getestet: OTA-Update, Validierung pe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
2026-09-14 BACKLOG und Paket-H-Plan: Stand 14.09. nachgetragen
    BACKLOG: Commits, Tags und Lösungskommentare zu V4.8.3 und V4.9.0 ergänzt.
    Paket-H-Plan: keine feste Versionsnummer mehr. Beim Start gilt die dann
    nächste freie Nummer; die Stufe hängt an den offenen Entscheidungen —
    MAJOR, wenn bestehende API-Clients ohne Zugangsdaten nicht mehr
    funktionieren, sonst MINOR.
2026-10-02 WIP: Regelabweichungsbalken-Glaettung (EMA + Marker-Hysterese)
    Anzeige-Tiefpass (DISP_SMOOTH 0.12, ~0.8 s) auf einen gemeinsamen
    Anzeigewert (Balken + grosse Zahl), plus 1-px-Marker-Hysterese, gegen
    das Zappeln durch Messrauschen. Regelung bleibt auf dem rohen Messwert.
    ACHTUNG: am Geraet NICHT verifiziert -- der OTA-Transfer kam in mehreren
    Versuchen nicht durch (receive failed / task watchdog / brownout), die
    Version ist also nie gebootet. Vor Merge nach main per USB flashen und
    Boot + Balkenverhalten pruefen. Version vorlaeufig V4.9.1 (beim Rebase auf main
    von V4.8.2 umgestellt, Version jetzt in version.txt).
    [display.cpp]
2026-10-02 Regelabweichungsbalken: progressiver Anzeigefilter (GitHub-#31)
    Der feste EMA-Tiefpass (0.12/Frame, ~0.8 s) wirkte am Geraet traege.
    Der Glaettungsfaktor waechst jetzt mit der Differenz zwischen Messwert
    und Anzeigewert: bis 0.3 V (Messrauschen) stark glaetten (~1.2 s), ab
    1.5 V praktisch sofort folgen (~0.1 s), dazwischen linear. Der Balken
    steht im eingeschwungenen Zustand ruhig und folgt Sollwertspruengen
    ohne spuerbare Verzoegerung; nach dem Einstellmenue holt die Anzeige
    den Messwert sofort ein. Die Regelung rechnet weiter mit dem Rohwert.
    Am Geraet per OTA getestet (Firmware und Filesystem V4.9.1).
2026-10-02 V4.9.1: Regelabweichungsbalken ruhiger (GitHub-#31)
    CHANGELOG-Eintrag abgeschlossen, README-Stand und BACKLOG nachgefuehrt. Am Geraet per OTA verifiziert (Firmware und Filesystem V4.9.1).
